david0ha/astra-cm5-nano/THIRD_PARTY.md

# Third-party notices

Original contributions are licensed under [CERN-OHL-P-2.0](LICENSE). The following material retains its own terms.

| Material | Attribution and terms |
|---|---|
| KiCad symbols and footprints embedded in the schematic and PCB | KiCad library contributors; CC-BY-SA-4.0 with the KiCad design-use exception. |
| `hardware/cm5-nano-compatible/NanoCompatible.pretty/SW_SPST_B3U-3000P.kicad_mod` and `USB3_A_Receptacle_Wuerth_692122030100_silk.kicad_mod` | Modified KiCad library footprints (silkscreen and property changes); CC-BY-SA-4.0 with the KiCad library exception. |
| `hardware/common/Carrier_Connectors.pretty/USB_C_GCT_USB4105_GroundClearance_020.kicad_mod` | Modified KiCad library footprint; ground-pad length changed from 1.15 mm to 1.10 mm. CC-BY-SA-4.0 with the KiCad library exception. |
| `hardware/cm5-nano-compatible/NanoCompatible.pretty/SDCARD_MOLEX_503398-1892.kicad_mod` and its embedded PCB copy | Raspberry Pi Ltd, CM5 IO Board footprint; 3D-model reference changed. Raspberry Pi design-file grant. |

KiCad library attribution and license: [official notice](https://www.kicad.org/libraries/license/), [library contributors](https://gitlab.com/kicad/libraries/), [included notice and exception](LICENSES/KiCad-library-license.md), [CC-BY-SA-4.0 full text](LICENSES/CC-BY-SA-4.0.txt).

Raspberry Pi attribution and terms: [official design-file licensing](https://www.raspberrypi.com/licensing/), [CM5 IO Board design files](https://pip.raspberrypi.com/categories/1098-design-files), [included grant and notice](LICENSES/Raspberry-Pi-design-notice.txt).

The original-contribution license does not relicense this material. Manufacturer 3D models and original Waveshare documents are not included. Product names identify their respective owners; no endorsement is implied.
