david0ha/astra-cm5-nano/docs/exports/schematic-focus-cm-pinmaps.png

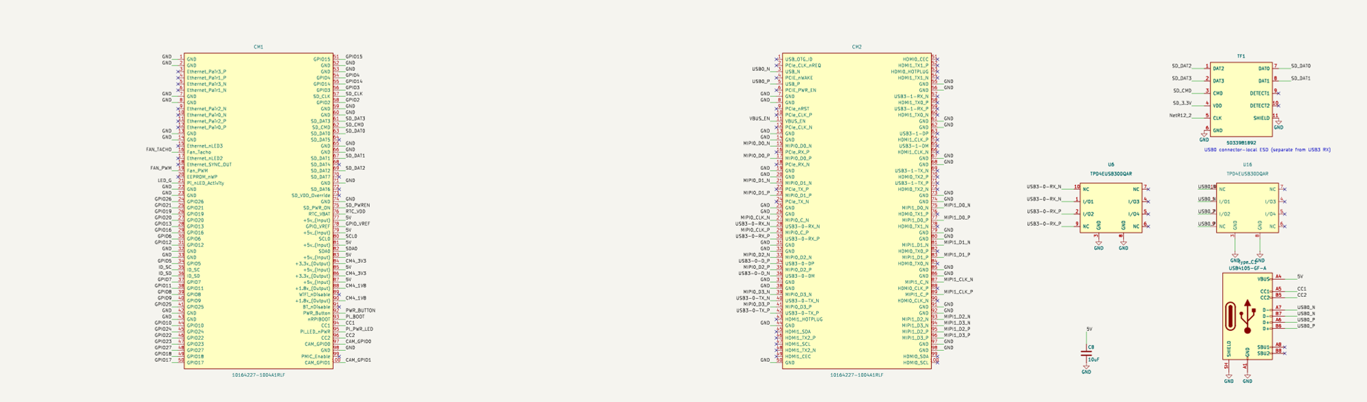
docs/exports/schematic-focus-cm-pinmaps.png
