david0ha/astra-cm5-nano/docs/exports/schematic-focus-mipi-gpio.png

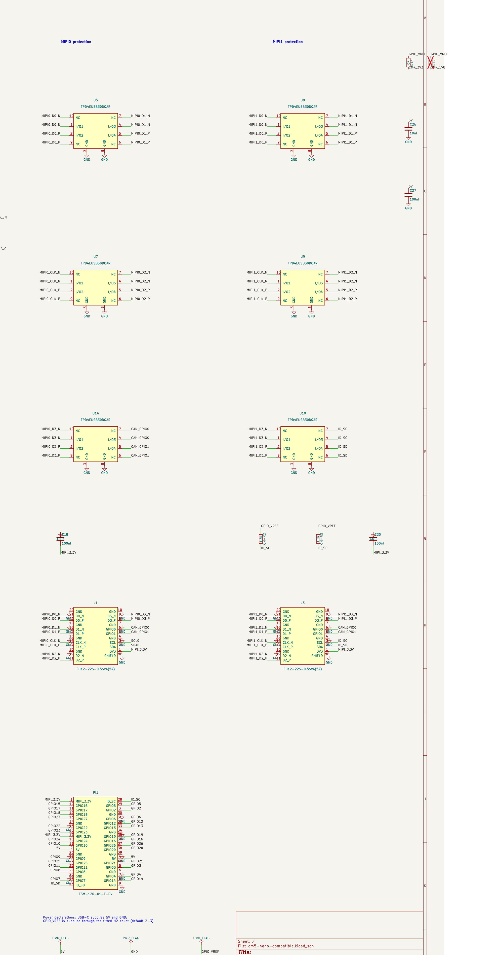
docs/exports/schematic-focus-mipi-gpio.png
