david0ha/astra-cm5-nano/docs/exports/schematic-focus-power-usb.png

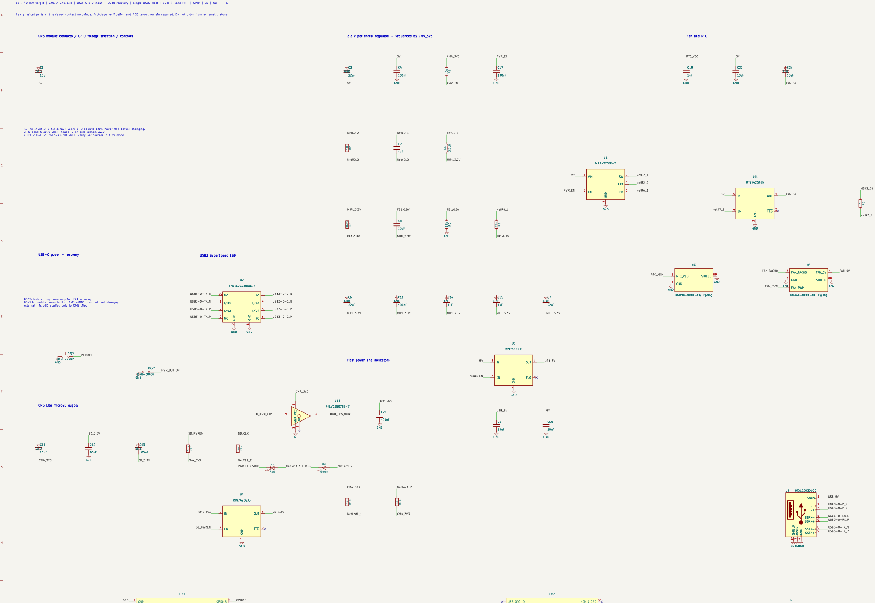
docs/exports/schematic-focus-power-usb.png
