david0ha/astra-cm5-nano/docs/exports/schematic-full.png

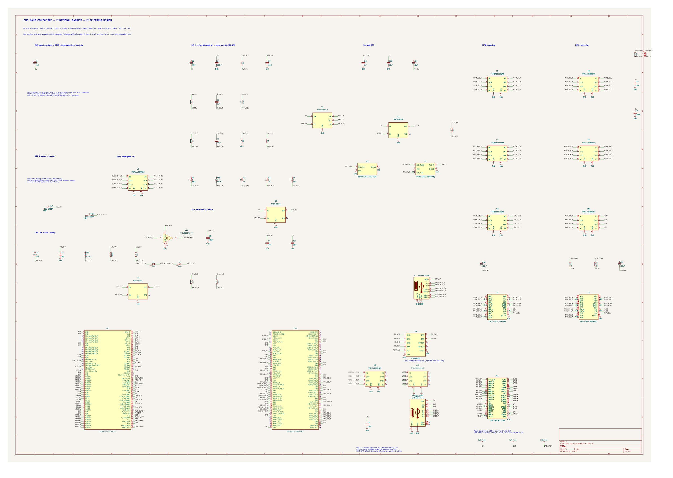
docs/exports/schematic-full.png
