david0ha/astra-cm5-nano/assembly/cm5-nano-compatible-BOM-detail.csv

Designator | Qty | Value | MPN | Footprint | LCSC | Catalogue MPN | MPN match | Stock as seen | Need for 5 boards | Library | URL | Sides | Mount
C1,C8,C9,C10,C11,C12,C23,C24,C26 | 9 | 10uF | GRM21BR61A106KE19L | Capacitor_SMD:C_0805_2012Metric | C77073 | GRM21BR61A106KE19L | exact | 8894 | 45 | expand | https://jlcpcb.com/partdetail/MurataElectronics-GRM21BR61A106KE19L/C77073 | B/F | SMD
C2,C14,C15,C19 | 4 | 1uF | GRM188R61A105KA61D | Capacitor_SMD:C_0603_1608Metric | C86012 | GRM188R61A105KA61D | exact | 37725 | 20 | expand | https://jlcpcb.com/partdetail/MurataElectronics-GRM188R61A105KA61D/C86012 | F | SMD
C3,C6,C7 | 3 | 22uF | CL21A226MQQNNNE | Capacitor_SMD:C_0805_2012Metric | C5674 | CL21A226MQQNNNE | exact | 4279129 | 15 | expand | https://jlcpcb.com/partdetail/6133-CL21A226MQQNNNE/C5674 | F | SMD
C4,C13,C16,C17,C18,C20,C25,C27 | 8 | 100nF | GRM188R71C104KA01D | Capacitor_SMD:C_0603_1608Metric | C45000 | GRM188R71C104KA01D | exact | 56256 | 40 | expand | https://jlcpcb.com/partdetail/MurataElectronics-GRM188R71C104KA01D/C45000 | B/F | SMD
C5 | 1 | 15pF | CL10C150JB8NNNC | Capacitor_SMD:C_0603_1608Metric | C1644 | CL10C150JB8NNNC | exact | 1044006 | 5 | base | https://jlcpcb.com/partdetail/1996-CL10C150JB8NNNC/C1644 | F | SMD
CM1,CM2 | 2 | 10164227-1004A1RLF | 10164227-1004A1RLF | Carrier_Connectors:Amphenol_10164227_1004A1RLF | C7435219 | 10164227-1004A1RLF | exact | 1118 | 10 | expand | https://jlcpcb.com/partdetail/AmphenolICC-101642271004A1RLF/C7435219 | B | SMD
CM-R2,CM-R3 | 2 | 1.8k | RC0402FR-071K8L | Resistor_SMD:R_0402_1005Metric | C163481 | RC0402FR-071K8L | exact | 351338 | 10 | expand | https://jlcpcb.com/partdetail/YAGEO-RC0402FR071K8L/C163481 | B | SMD
D1 | 1 | Red | LTST-C190KRKT | LED_SMD:LED_0603_1608Metric | C94869 | LTST-C190KRKT | exact | 388879 | 5 | expand | https://jlcpcb.com/partdetail/LiteOn-LTSTC190KRKT/C94869 | F | SMD
D2 | 1 | Green | LTST-C190KGKT | LED_SMD:LED_0603_1608Metric | C125094 | LTST-C190KGKT | exact | 740086 | 5 | expand | https://jlcpcb.com/partdetail/LiteOn-LTSTC190KGKT/C125094 | F | SMD
H3 | 1 | BM02B-SRSS-TB(LF)(SN) | BM02B-SRSS-TB(LF)(SN) | Connector_JST:JST_SH_BM02B-SRSS-TB_1x02-1MP_P1.00mm_Vertical | C160388 | BM02B-SRSS-TB(LF)(SN) | exact | 31049 | 5 | expand | https://jlcpcb.com/partdetail/JST-BM02B_SRSS_TB_LF_SN/C160388 | F | SMD
H4 | 1 | BM04B-SRSS-TB(LF)(SN) | BM04B-SRSS-TB(LF)(SN) | Connector_JST:JST_SH_BM04B-SRSS-TB_1x04-1MP_P1.00mm_Vertical | C160390 | BM04B-SRSS-TB(LF)(SN) | exact | 53090 | 5 | expand | https://jlcpcb.com/partdetail/JST-BM04B_SRSS_TB_LF_SN/C160390 | F | SMD
J1,J3 | 2 | FH12-22S-0.5SVA(54) | FH12-22S-0.5SVA(54) | NanoCompatible:Hirose_FH12-22S-0.5SVA_22P_Vertical | C6250833 | FH12-22S-0.5SVA(54) | exact | 45 | 10 | expand | https://jlcpcb.com/partdetail/HRS_Hirose-FH12_22S_0_5SVA_54/C6250833 | F | SMD
J2 | 1 | 692122030100 | 692122030100 | NanoCompatible:USB3_A_Receptacle_Wuerth_692122030100_silk | C5355286 | 692122030100 | exact | 78 | 5 | expand | https://jlcpcb.com/partdetail/WurthElektronik-692122030100/C5355286 | F | SMD
Key1,Key2 | 2 | B3U-3000P | B3U-3000P | NanoCompatible:SW_SPST_B3U-3000P | C963349 | B3U-3000P | exact | 22033 | 10 | expand | https://jlcpcb.com/partdetail/OmronElectronics-B3U3000P/C963349 | F | SMD
L1 | 1 | 3.3uH | XAL5030-332MEC | Inductor_SMD:L_Coilcraft_XAL5030-XXX | C5342047 | XAL5030-332MEC | exact | 513 | 5 | expand | https://jlcpcb.com/partdetail/Coilcraft-XAL5030332MEC/C5342047 | F | SMD
PI1 | 1 | TSM-120-01-T-DV | TSM-120-01-T-DV | NanoCompatible:Samtec_TSM-120-01-L-DV-P-TR_2x20_P2.54mm | C6723336 | TSM-120-01-T-DV | exact | 57 | 5 | expand | https://jlcpcb.com/partdetail/Samtec-TSM_120_01_TDV/C6723336 | F | SMD
R2 | 1 | 10 | RC0402FR-0710RL | Resistor_SMD:R_0402_1005Metric | C138066 | RC0402FR-0710RL | exact | 1355467 | 5 | expand | https://jlcpcb.com/partdetail/YAGEO-RC0402FR0710RL/C138066 | F | SMD
R3 | 1 | 40.2k | RC0402FR-0740K2L | Resistor_SMD:R_0402_1005Metric | C137983 | RC0402FR-0740K2L | exact | 1453343 | 5 | expand | https://jlcpcb.com/partdetail/YAGEO-RC0402FR0740K2L/C137983 | F | SMD
R5,R15 | 2 | 10k | RC0402FR-0710KL | Resistor_SMD:R_0402_1005Metric | C60490 | RC0402FR-0710KL | exact | 8053789 | 10 | expand | https://jlcpcb.com/partdetail/YAGEO-RC0402FR0710KL/C60490 | B/F | SMD
R6 | 1 | 75k | RC0402FR-0775KL | Resistor_SMD:R_0402_1005Metric | C137935 | RC0402FR-0775KL | exact | 167963 | 5 | expand | https://jlcpcb.com/partdetail/YAGEO-RC0402FR0775KL/C137935 | F | SMD
R7 | 1 | 0 | RC0402JR-070RL | Resistor_SMD:R_0402_1005Metric | C60485 | RC0402JR-070RL | exact | 8573741 | 5 | expand | https://jlcpcb.com/partdetail/YAGEO-RC0402JR070RL/C60485 | F | SMD
R9 | 1 | 13k | RC0402FR-0713KL | Resistor_SMD:R_0402_1005Metric | C138057 | RC0402FR-0713KL | exact | 385344 | 5 | expand | https://jlcpcb.com/partdetail/YAGEO-RC0402FR0713KL/C138057 | F | SMD
R10,R11 | 2 | 1k | RC0402FR-071KL | Resistor_SMD:R_0402_1005Metric | C106235 | RC0402FR-071KL | exact | 2606729 | 10 | expand | https://jlcpcb.com/partdetail/YAGEO-RC0402FR071KL/C106235 | B | SMD
R12 | 1 | 22 | RC0402FR-0722RL | Resistor_SMD:R_0402_1005Metric | C114765 | RC0402FR-0722RL | exact | 3732049 | 5 | expand | https://jlcpcb.com/partdetail/YAGEO-RC0402FR0722RL/C114765 | B | SMD
R16 | 1 | 0R | RC0402FR-070RL | Resistor_SMD:R_0402_1005Metric | C106231 | RC0402FR-070RL | exact | 326002 | 5 | expand | https://jlcpcb.com/partdetail/YAGEO-RC0402FR070RL/C106231 | F | SMD
TF1 | 1 | 5033981892 | 5033981892 | NanoCompatible:SDCARD_MOLEX_503398-1892 | C428492 | 5033981892 | exact | 23982 | 5 | expand | https://jlcpcb.com/partdetail/MOLEX-5033981892/C428492 | F | SMD
Type_C1 | 1 | USB4105-GF-A | USB4105-GF-A | Carrier_Connectors:USB_C_GCT_USB4105_GroundClearance_020 | C3020560 | USB4105-GF-A | exact | 777 | 5 | expand | https://jlcpcb.com/partdetail/3542626-USB4105_GFA/C3020560 | F | SMD
U1 | 1 | MP1477GTF-Z | MP1477GTF-Z | NanoCompatible:MP1658_SOT563_MPS | C3193189 | MP1477GTF-Z | exact | 101 | 5 | expand | https://jlcpcb.com/partdetail/Monolithic_PowerSystems-MP1477GTFZ/C3193189 | F | SMD
U2,U5,U6,U7,U8,U10,U14,U16 | 8 | TPD4EUSB30DQAR | TPD4EUSB30DQAR | Carrier_Connectors:TI_TPD4EUSB30_DQA0010A | C90627 | TPD4EUSB30DQAR | exact | 41267 | 40 | expand | https://jlcpcb.com/partdetail/TexasInstruments-TPD4EUSB30DQAR/C90627 | B/F | SMD
U3 | 1 | RT9742CGJ5 | RT9742CGJ5 | Package_TO_SOT_SMD:SOT-23-5 | C250546 | RT9742CGJ5 | exact | 17543 | 5 | expand | https://jlcpcb.com/partdetail/RichtekTech-RT9742CGJ5/C250546 | F | SMD
U4,U11 | 2 | RT9742GGJ5 | RT9742GGJ5 | Package_TO_SOT_SMD:SOT-23-5 | C250547 | RT9742GGJ5 | exact | 13072 | 10 | expand | https://jlcpcb.com/partdetail/RichtekTech-RT9742GGJ5/C250547 | F | SMD
U9 | 1 | TPD4EUSB30DQAR | TPD4EUSB30DQAR | NanoCompatible:TI_TPD4EUSB30_DQA0010A_U9 | C90627 | TPD4EUSB30DQAR | exact | 41267 | 5 | expand | https://jlcpcb.com/partdetail/TexasInstruments-TPD4EUSB30DQAR/C90627 | B | SMD
U15 | 1 | 74LVC1G07SE-7 | 74LVC1G07SE-7 | NanoCompatible:74LVC1G07_SOT353_Diodes | C67531 | 74LVC1G07SE-7 | exact | 10668 | 5 | expand | https://jlcpcb.com/partdetail/DiodesIncorporated-74LVC1G07SE7/C67531 | B | SMD
