david0ha/astra-cm5-nano/docs/exports/schematic-focused-pages.pdf

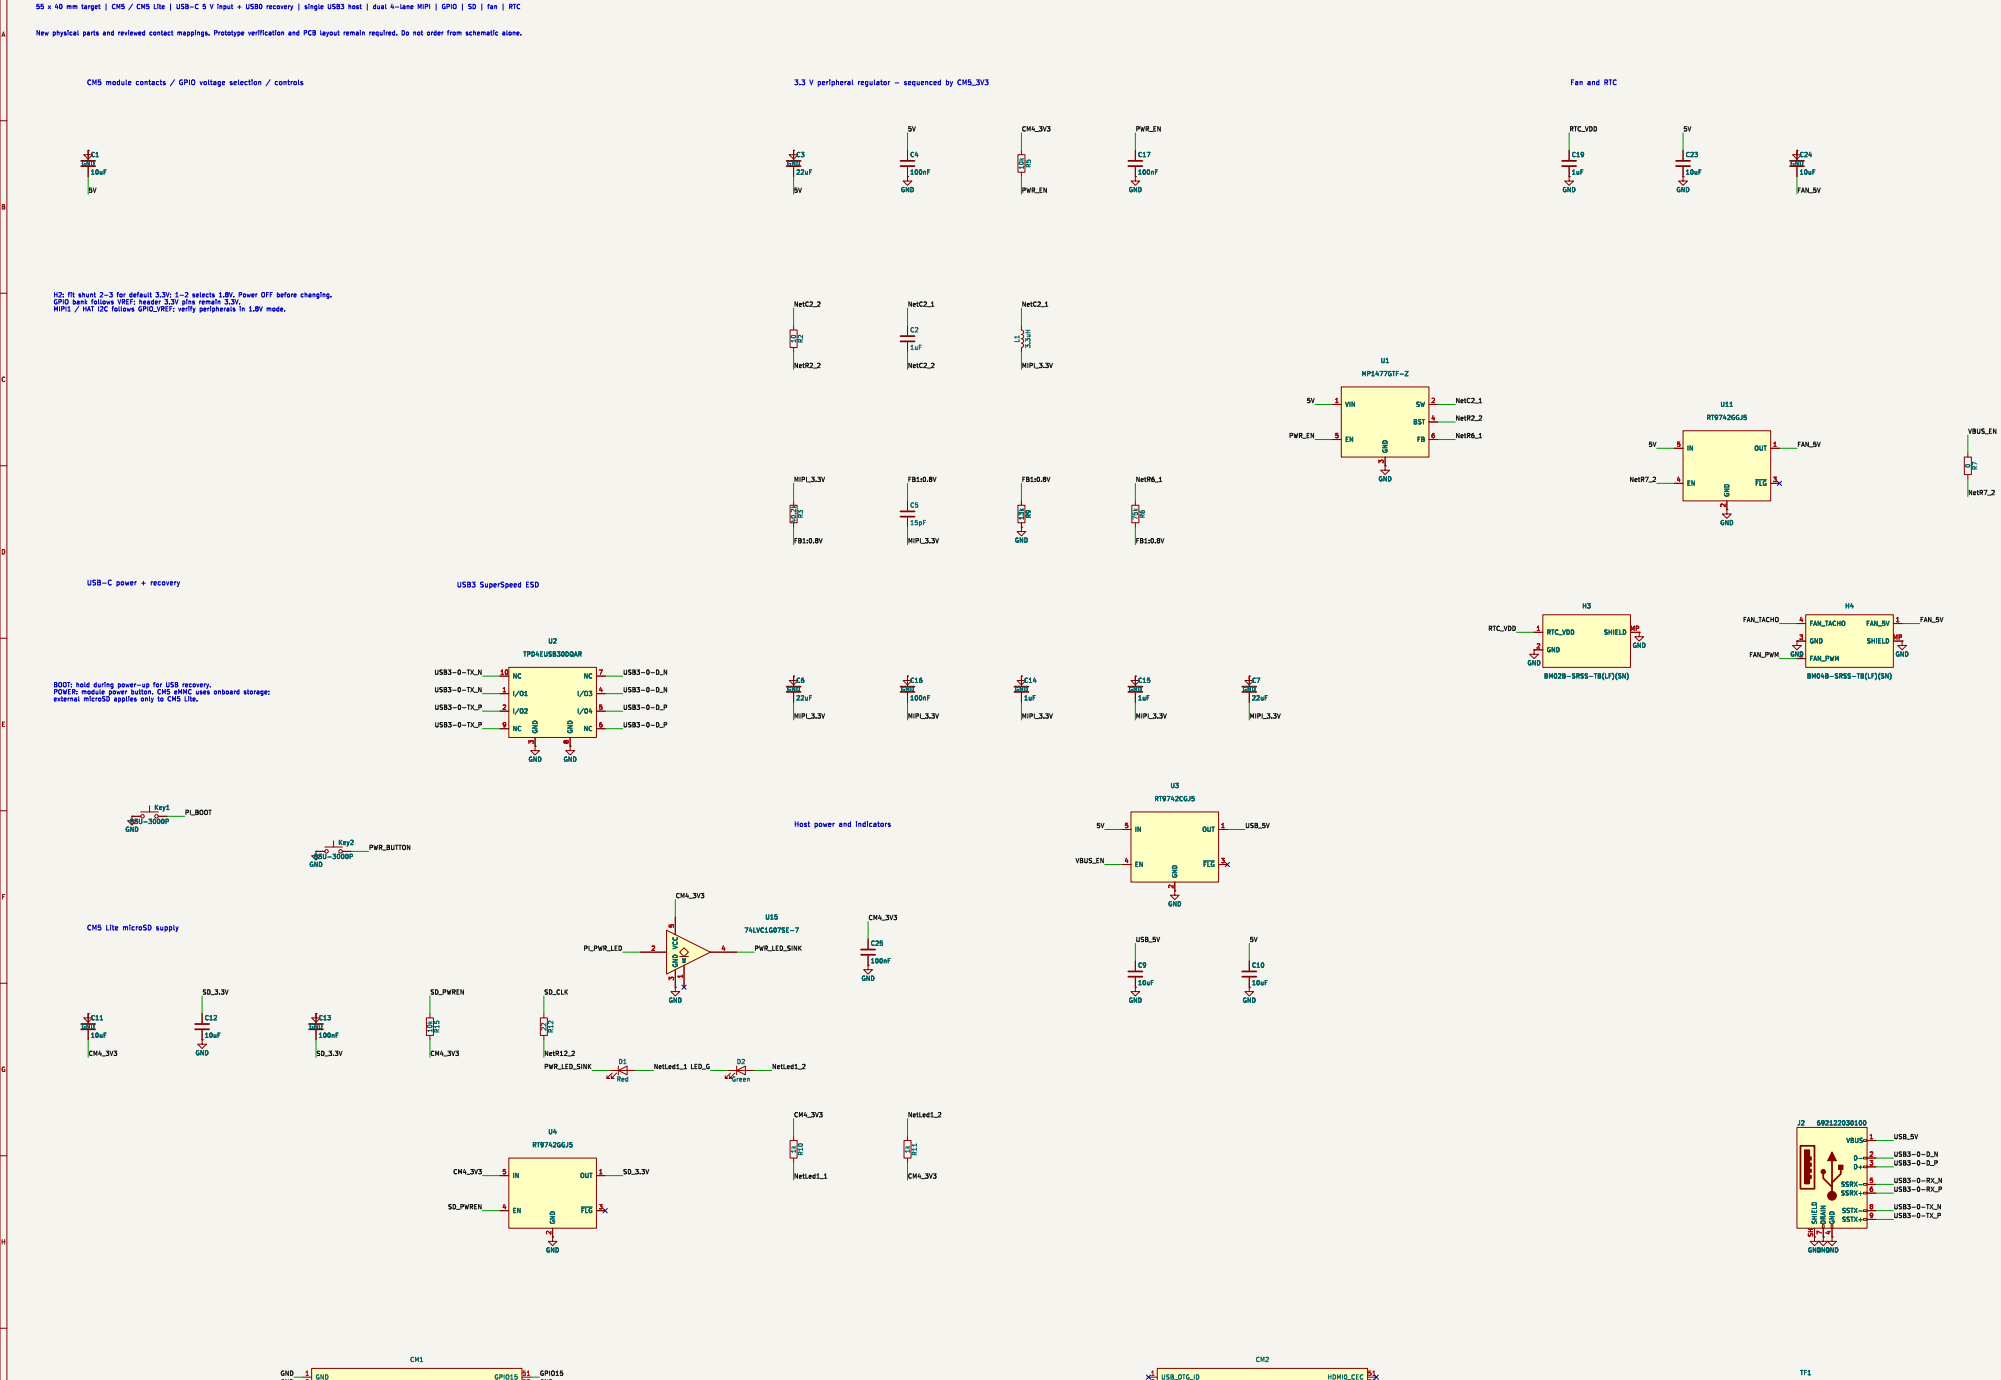
[picture p7: page 1]

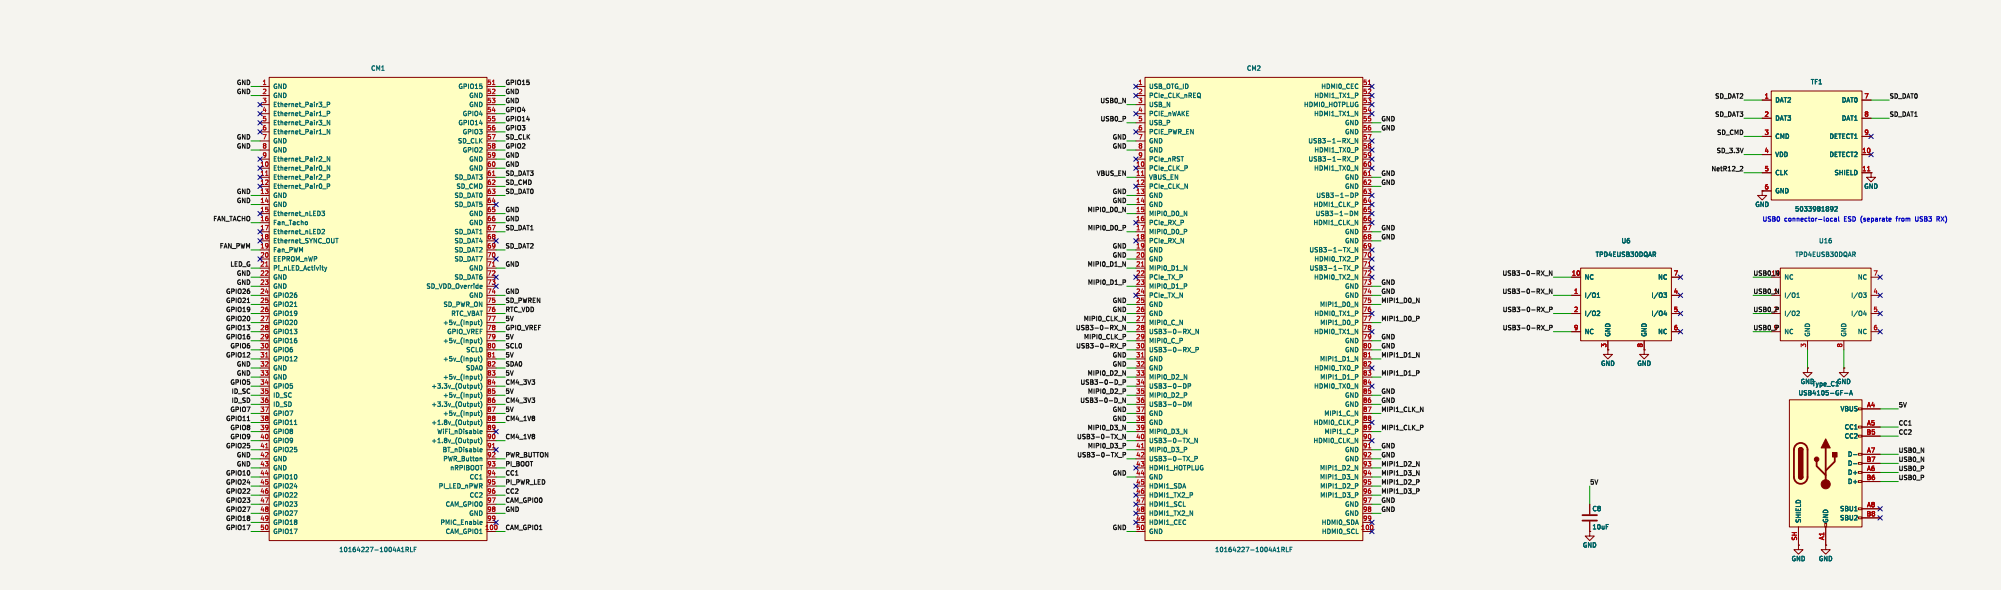
[picture p8: page 2]

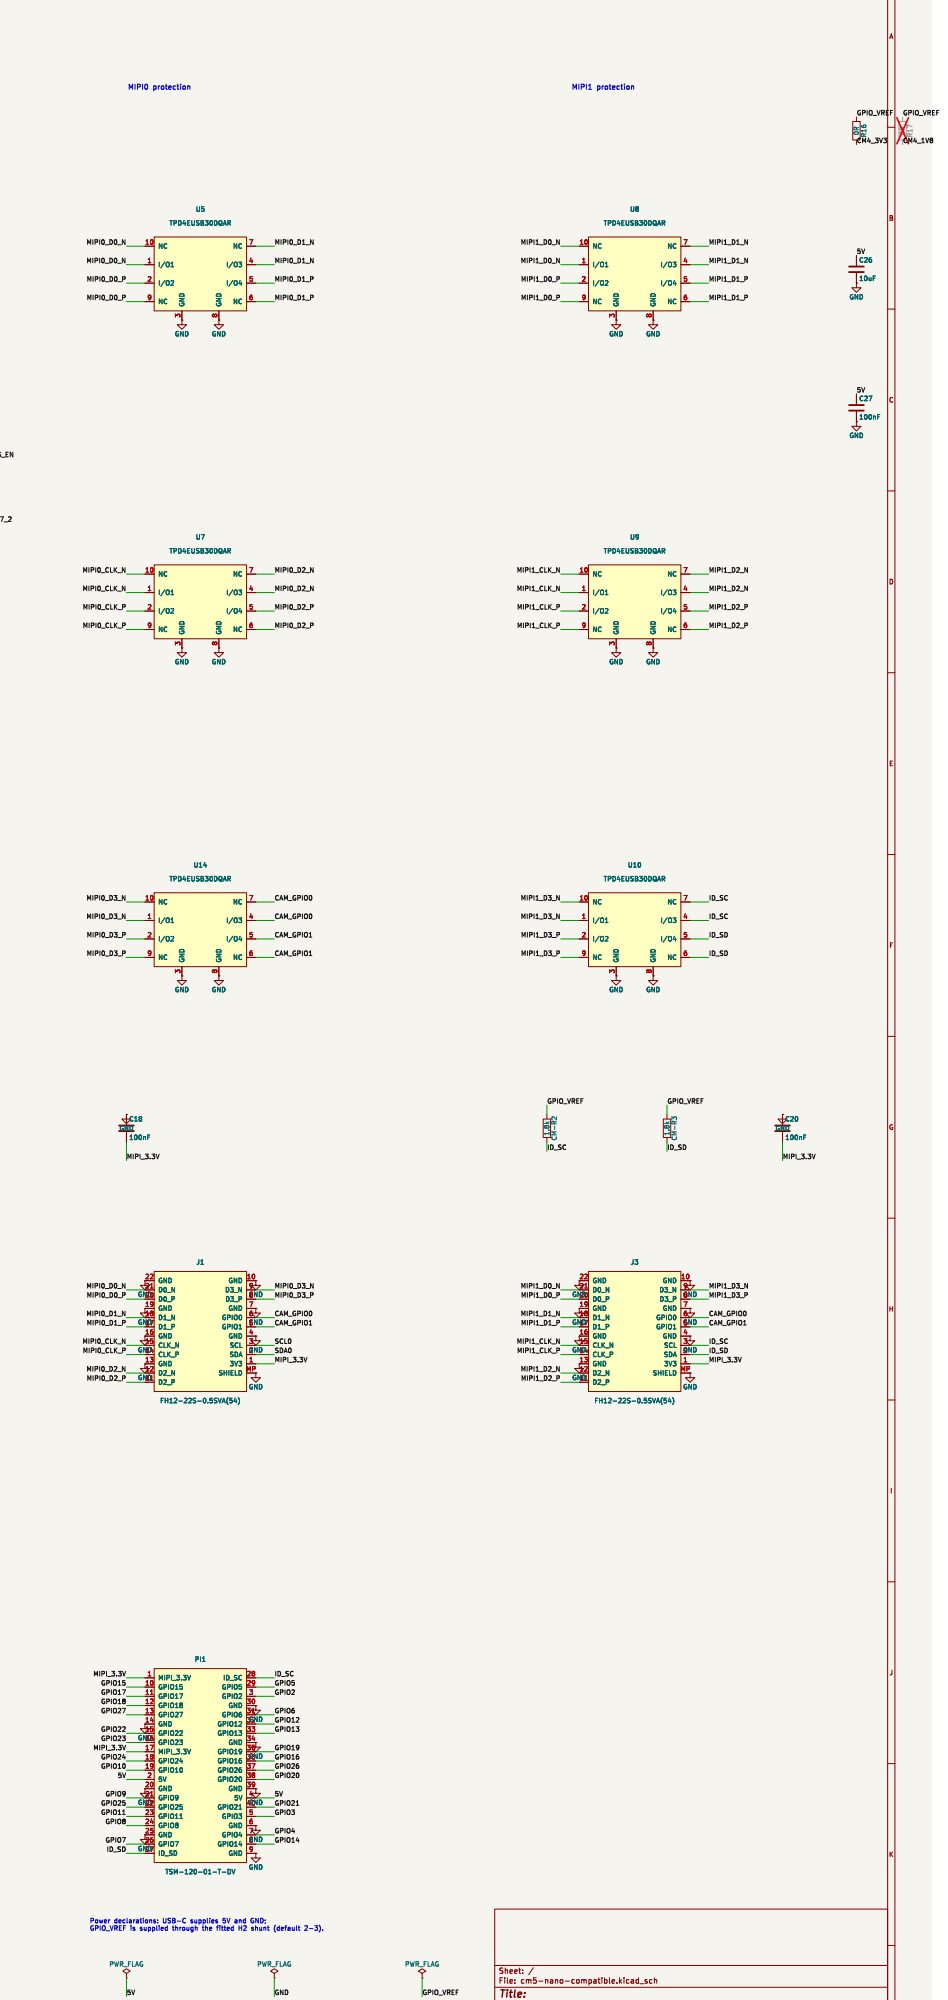
[picture p9: page 3]
