david0ha/astra-cm5-nano/docs/exports/schematic-full.pdf

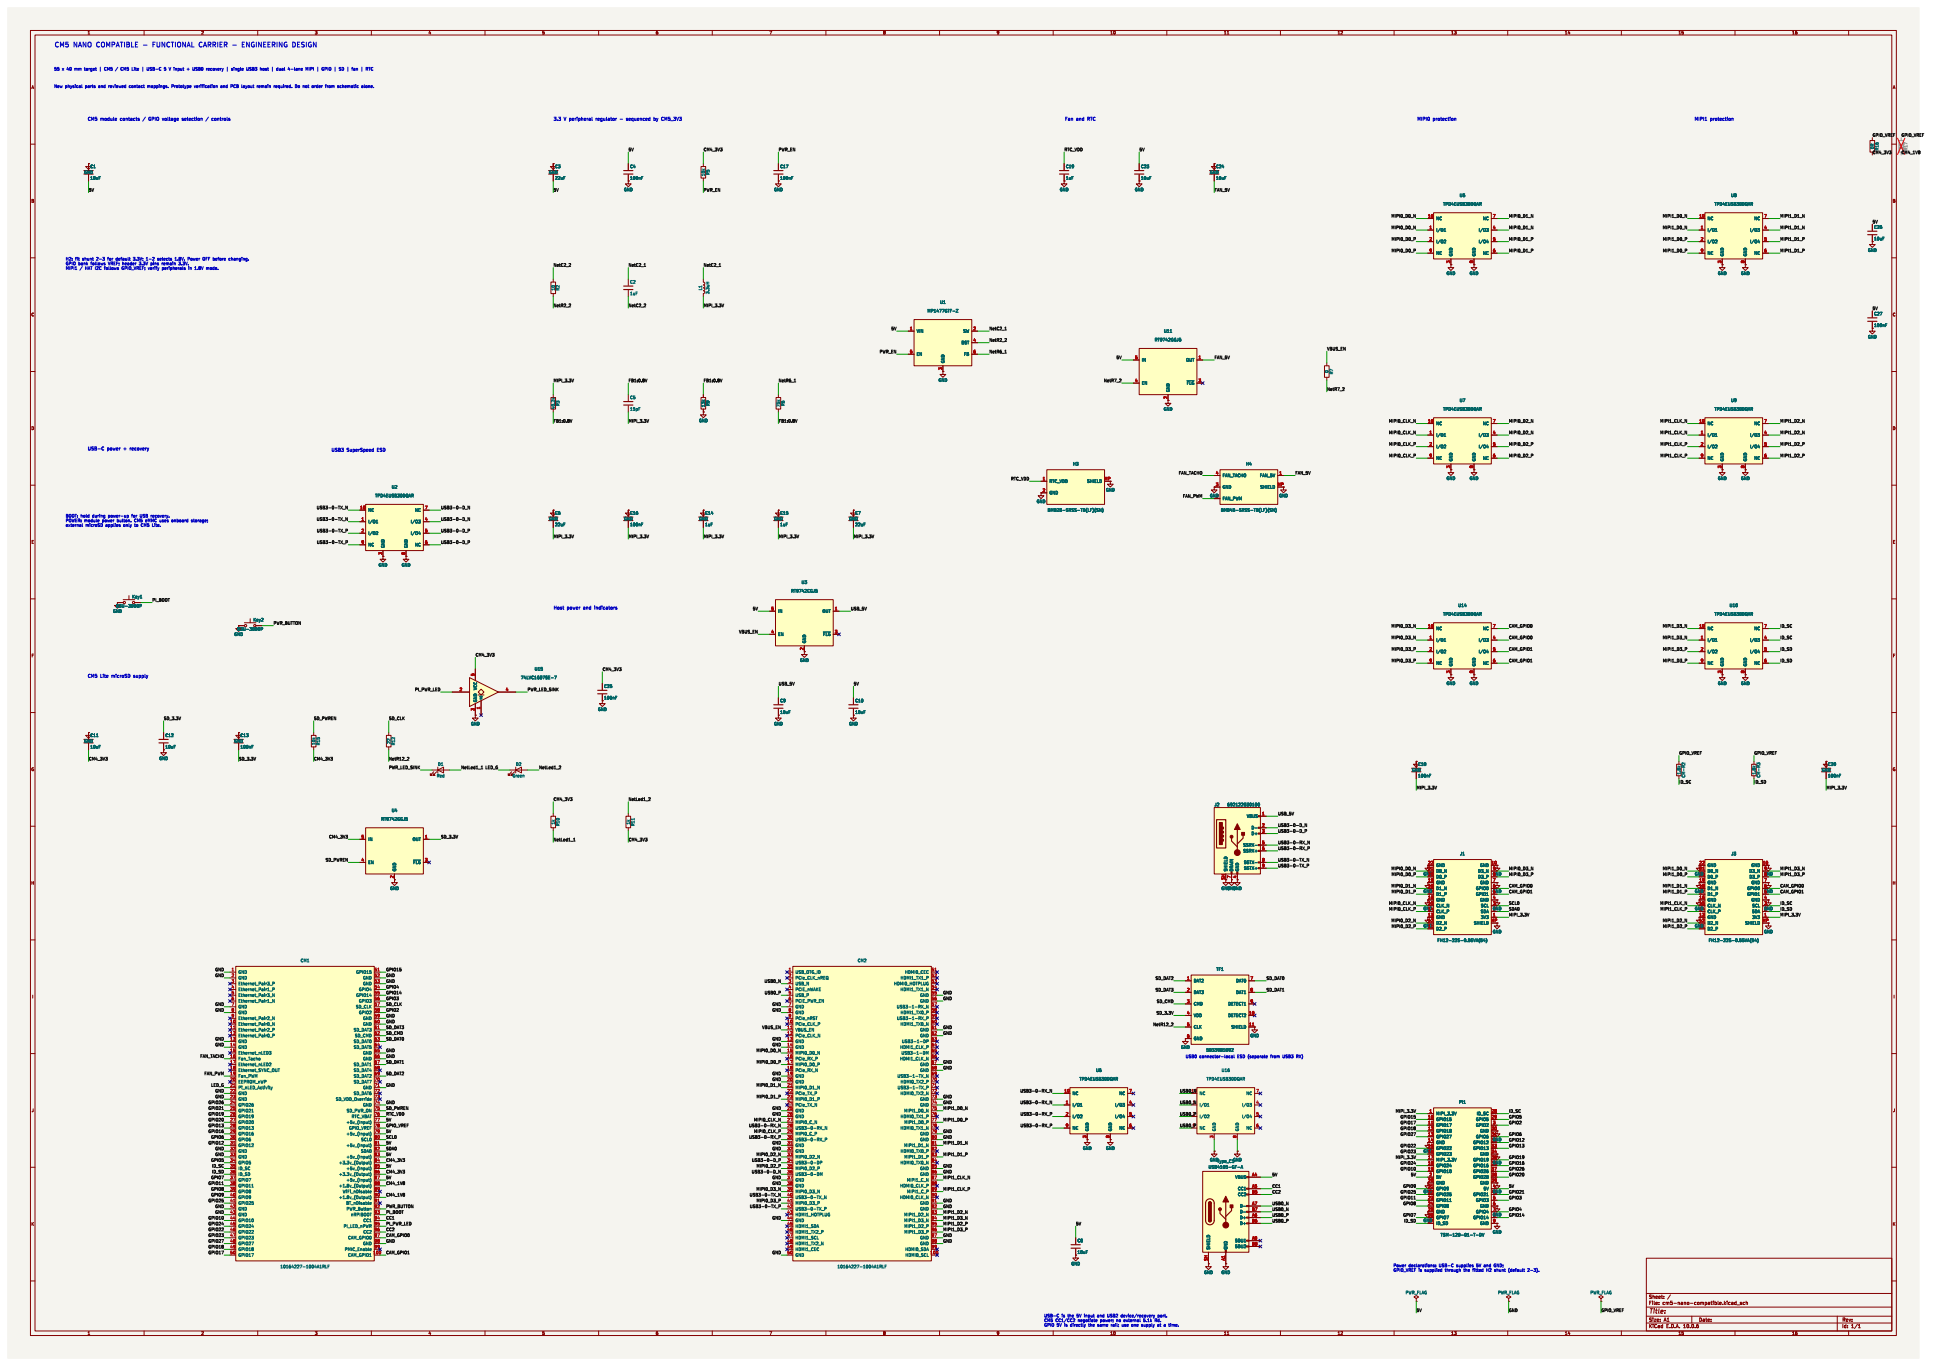
[picture p10: page 1]
