david0ha/astra-cm5-nano/docs/exports/pcb-layers.pdf

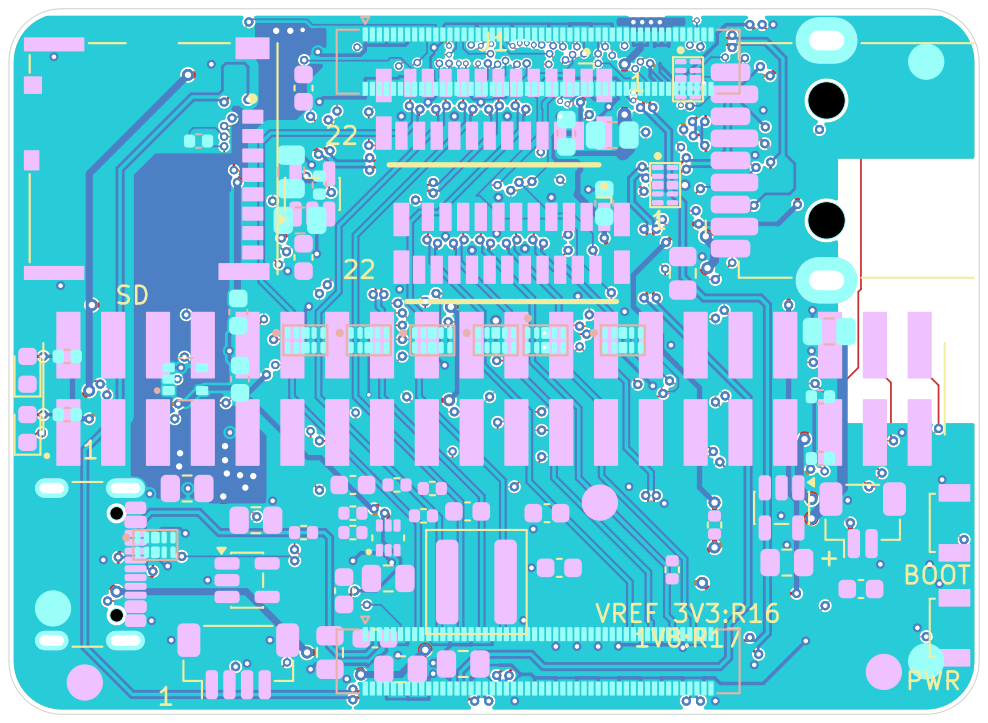
[picture p11: page 1]
