david0ha/astra-cm5-nano/hardware/cm5-nano-compatible/cm5-nano-compatible.kicad_pcb

## KiCad design hardware/cm5-nano-compatible/cm5-nano-compatible.kicad_pcb (2026-10-02)

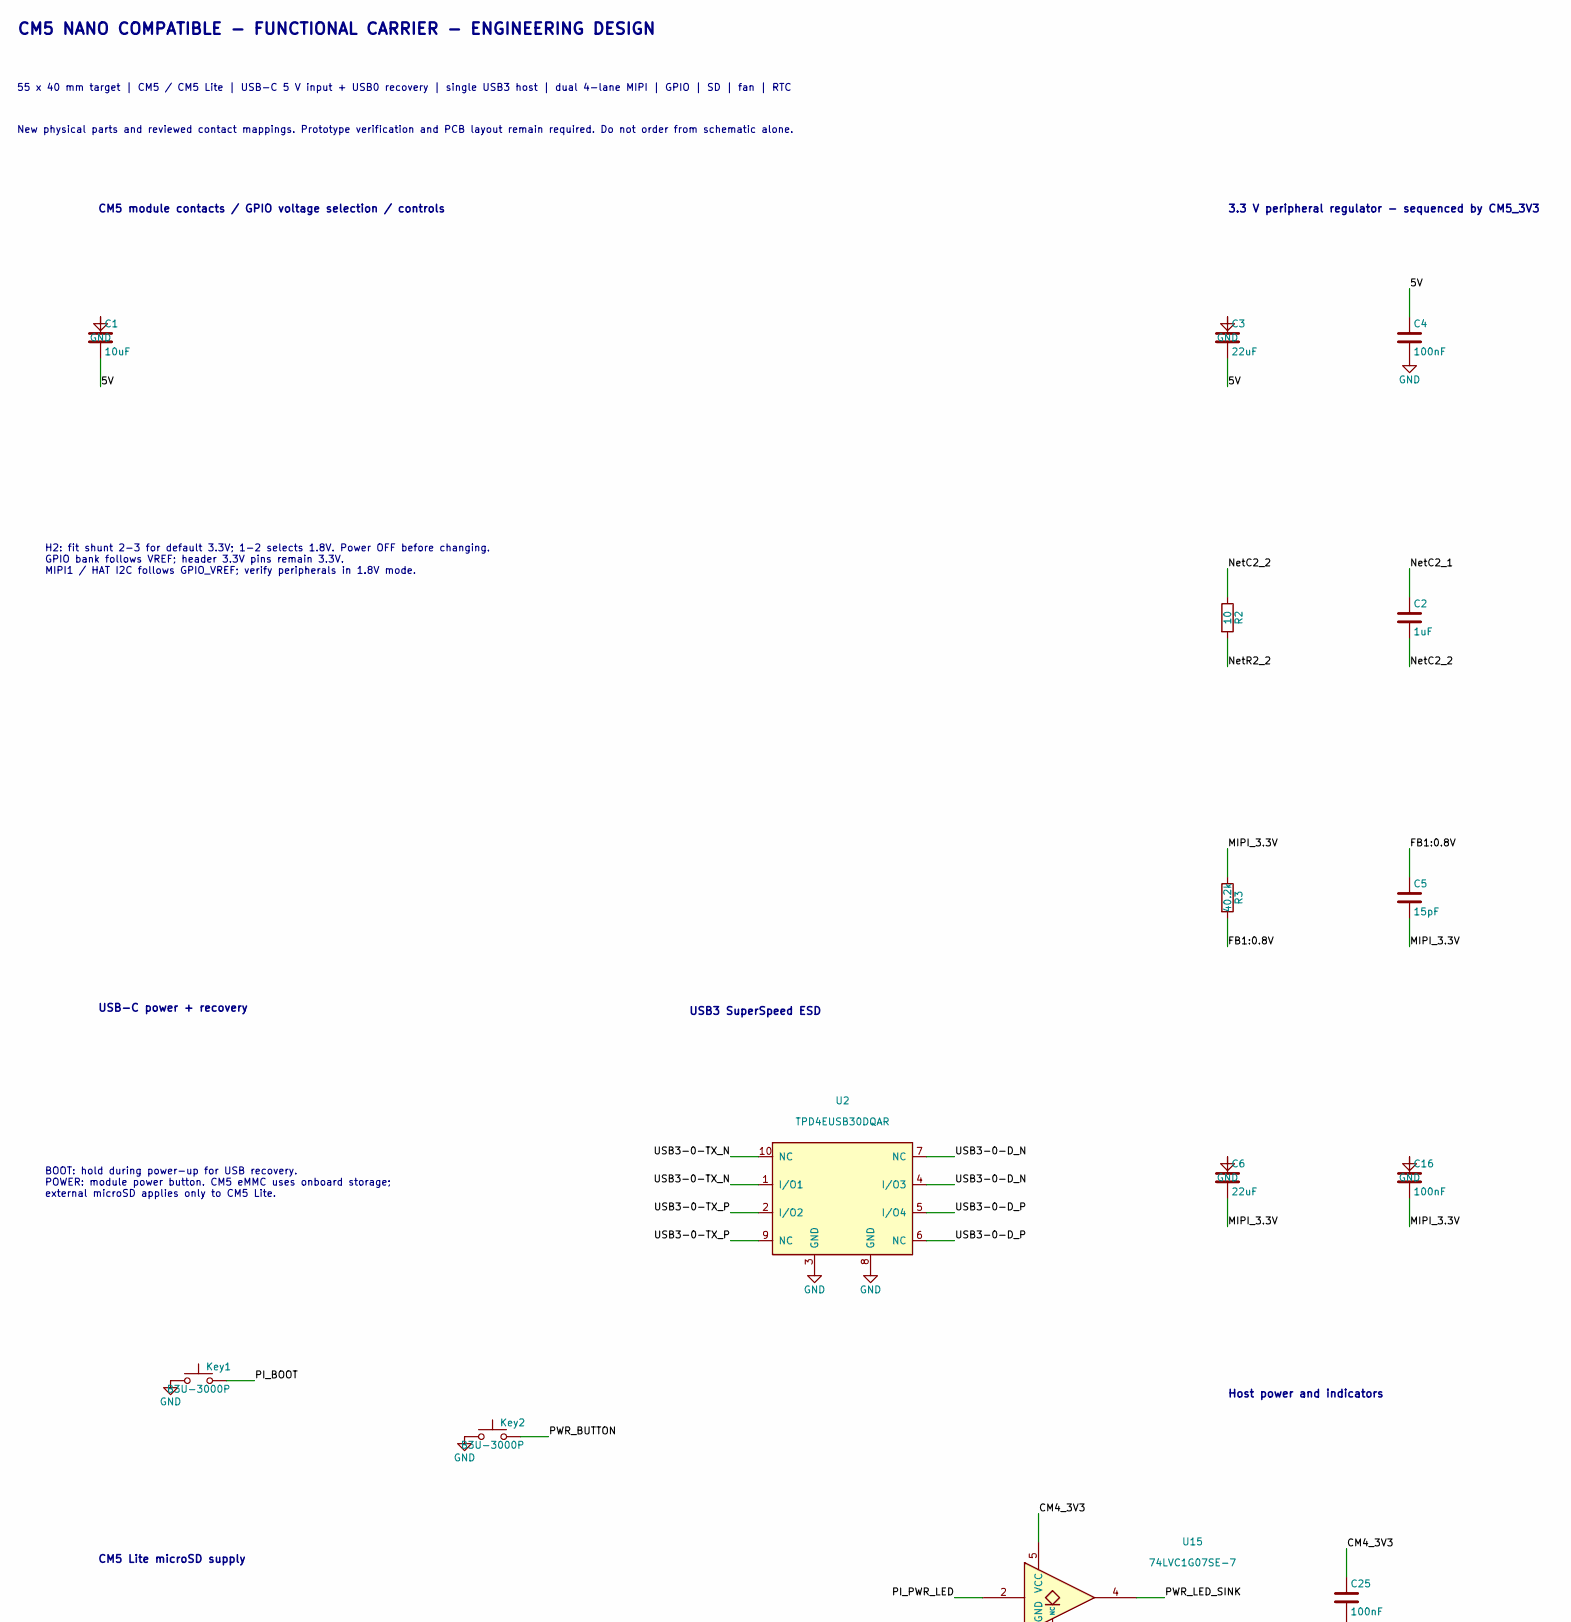
[picture p12: schematic cm5-nano-compatible.kicad_sch, part in row 1, column 1]

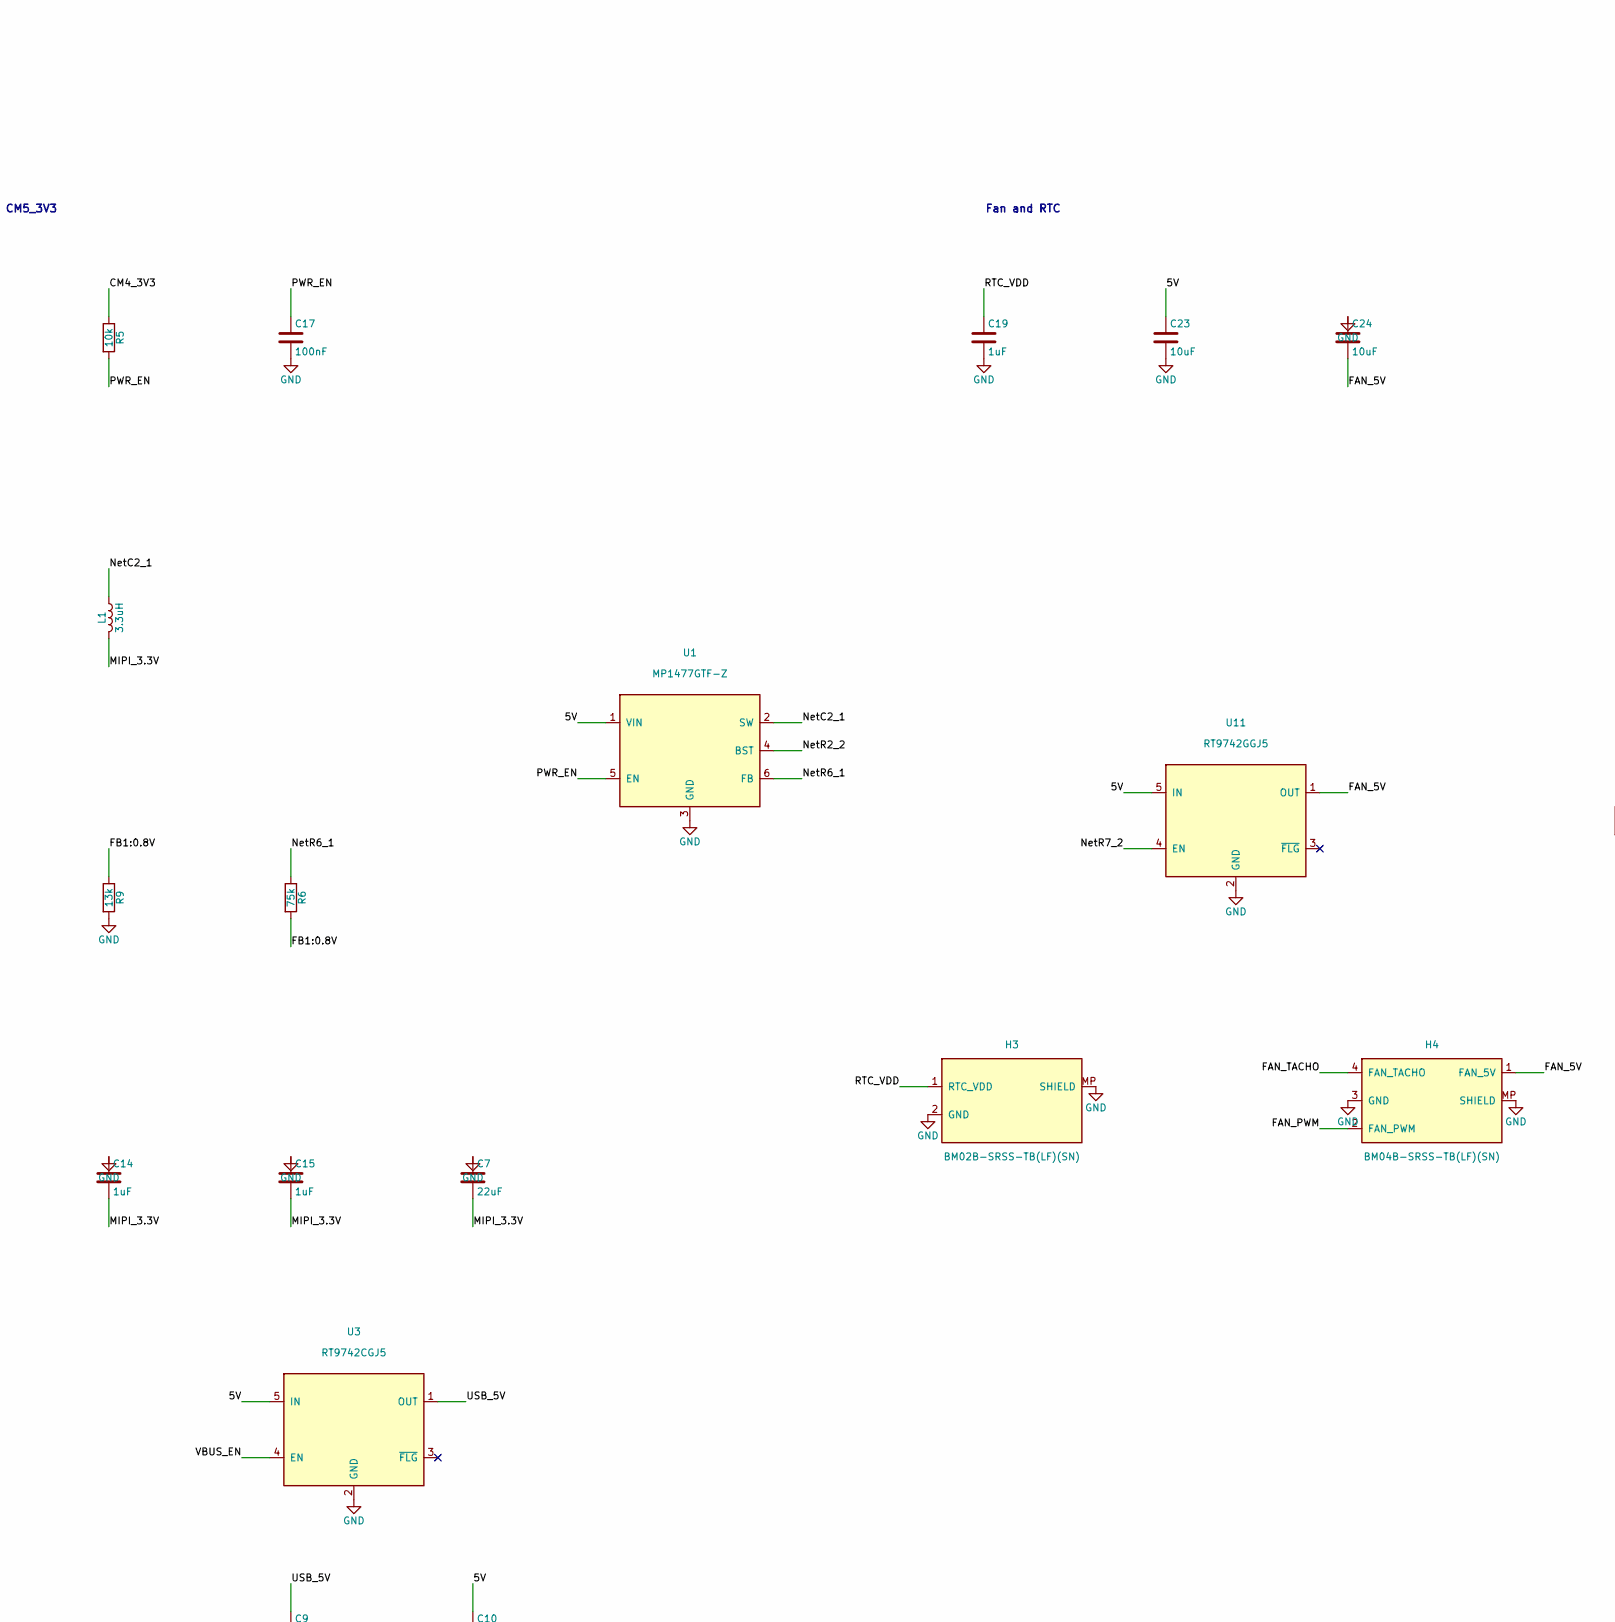
[picture p13: schematic cm5-nano-compatible.kicad_sch, part in row 1, column 2]

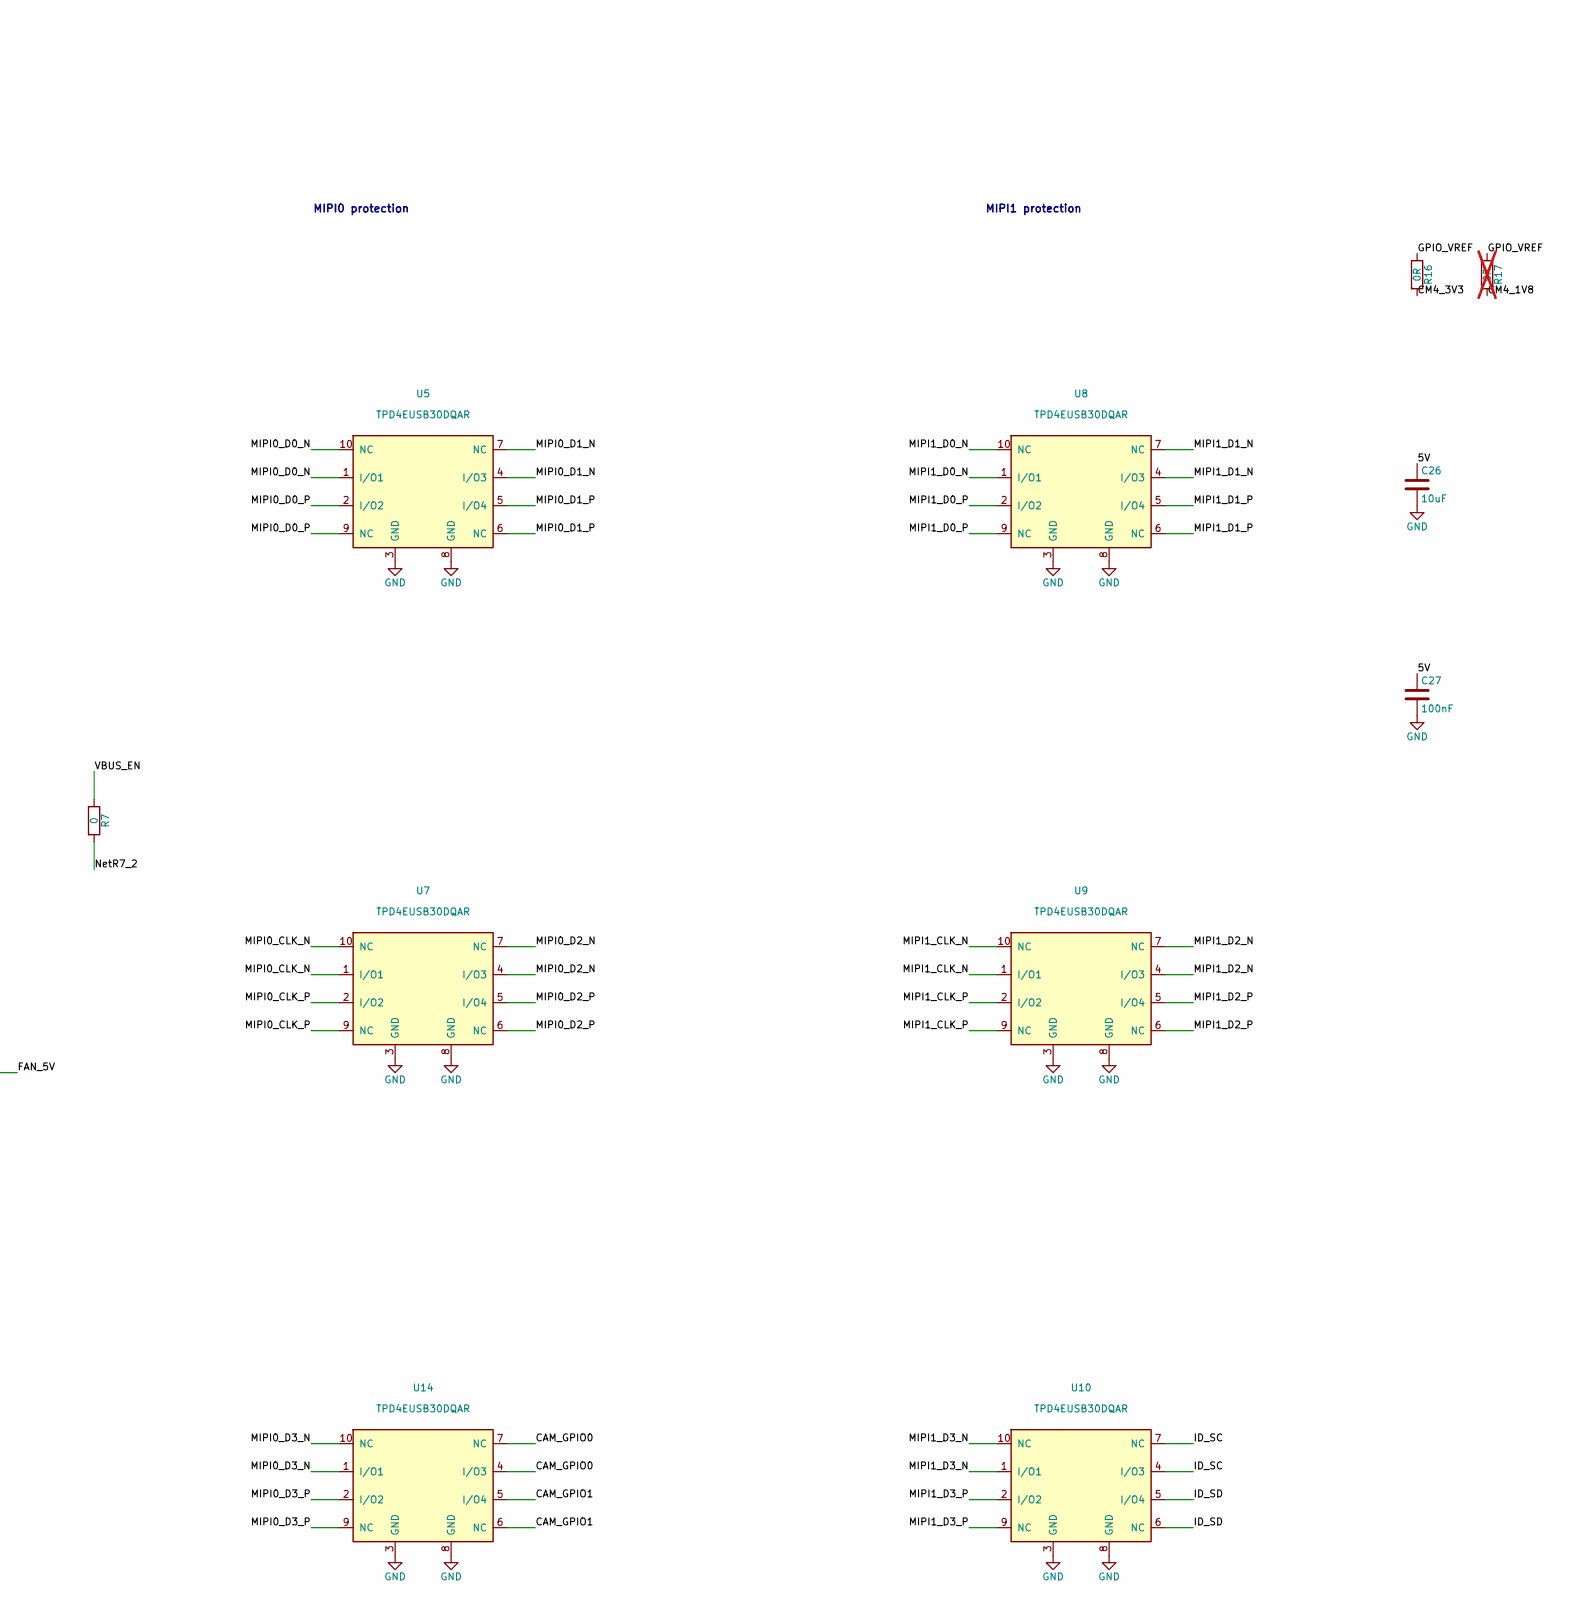
[picture p14: schematic cm5-nano-compatible.kicad_sch, part in row 1, column 3]

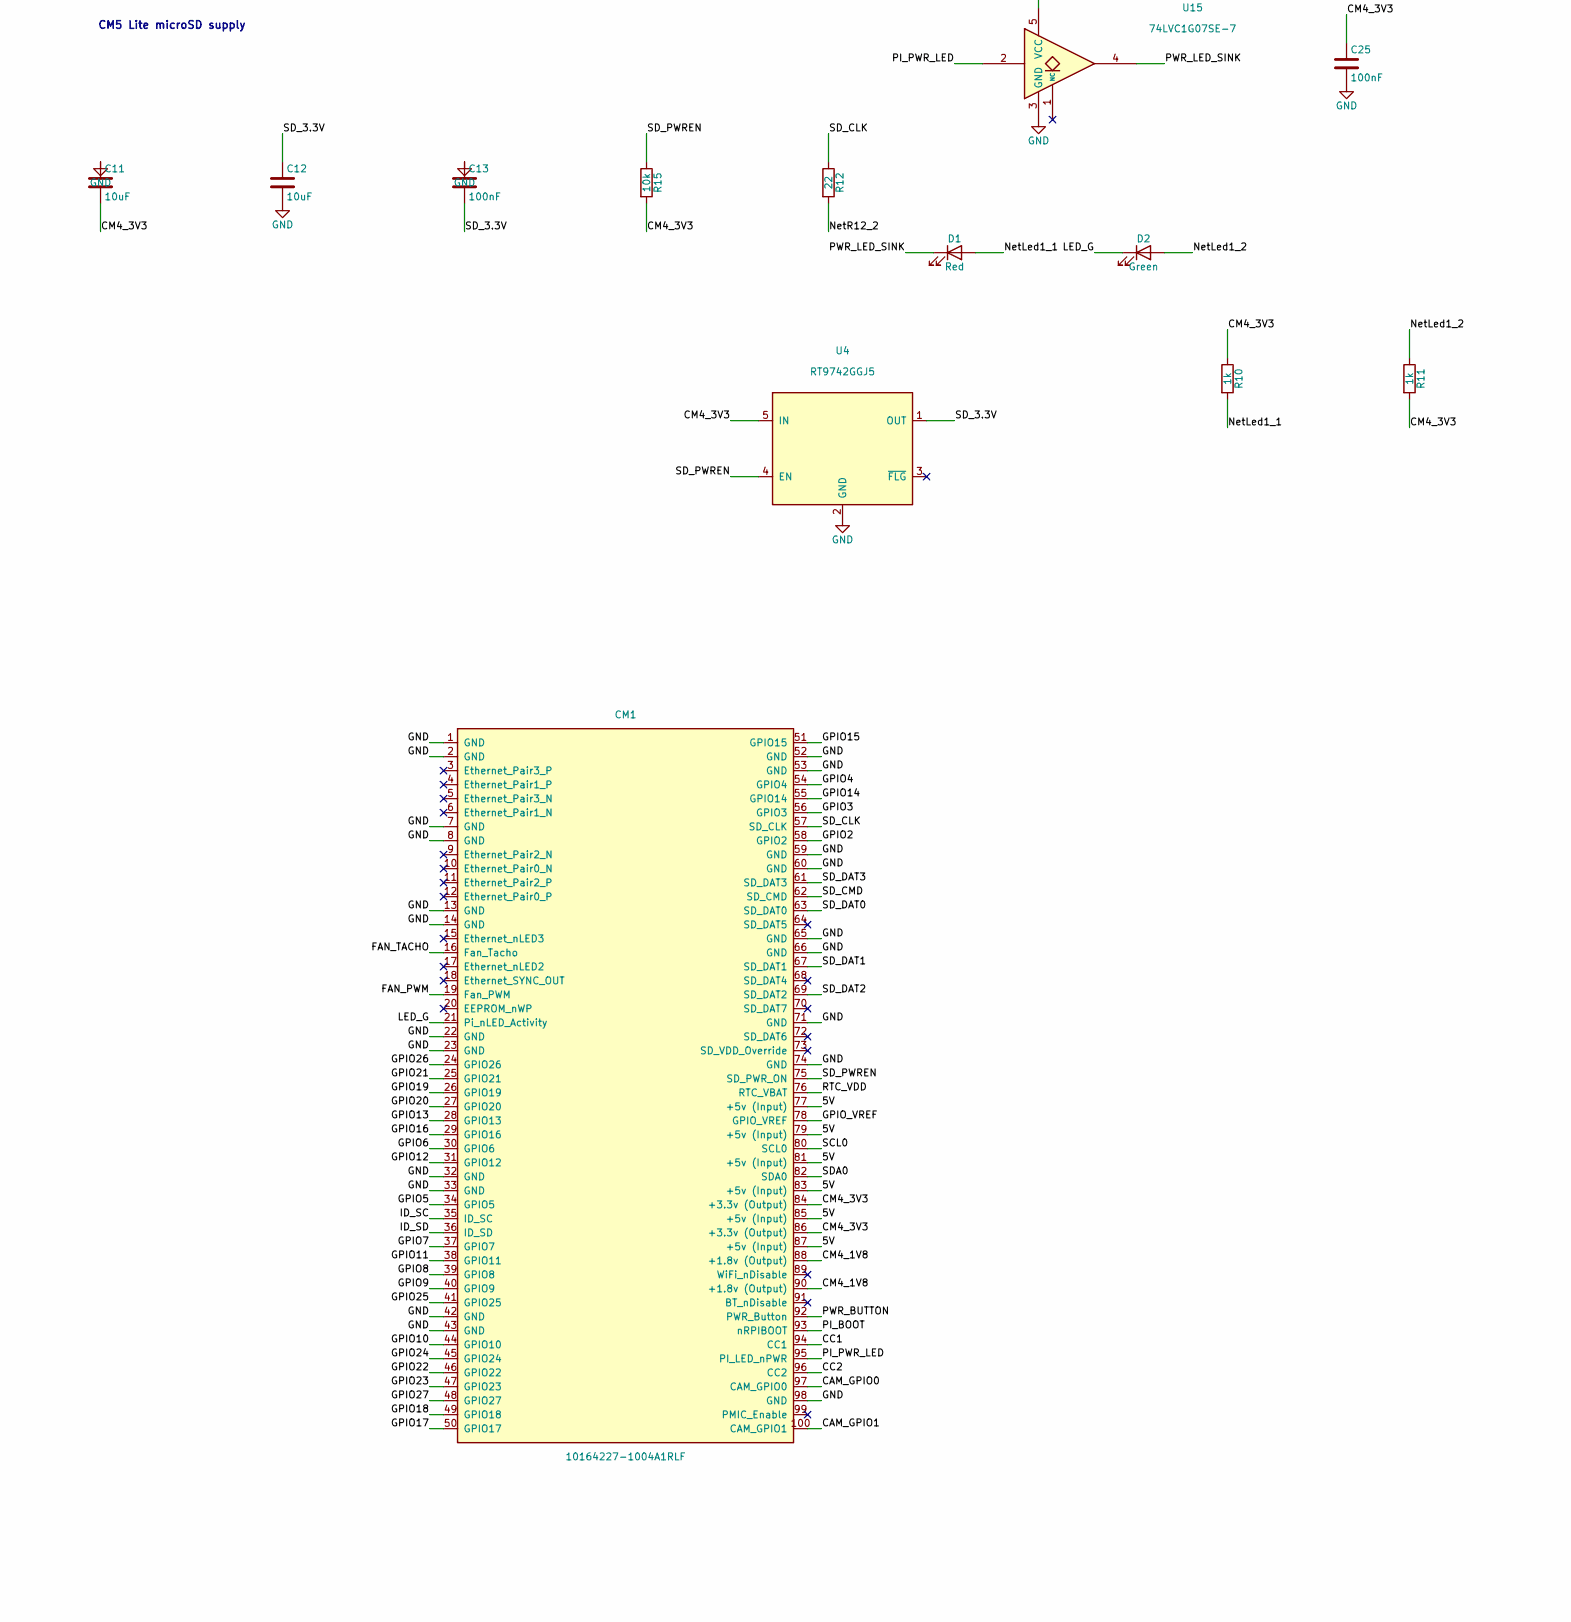
[picture p15: schematic cm5-nano-compatible.kicad_sch, part in row 2, column 1]

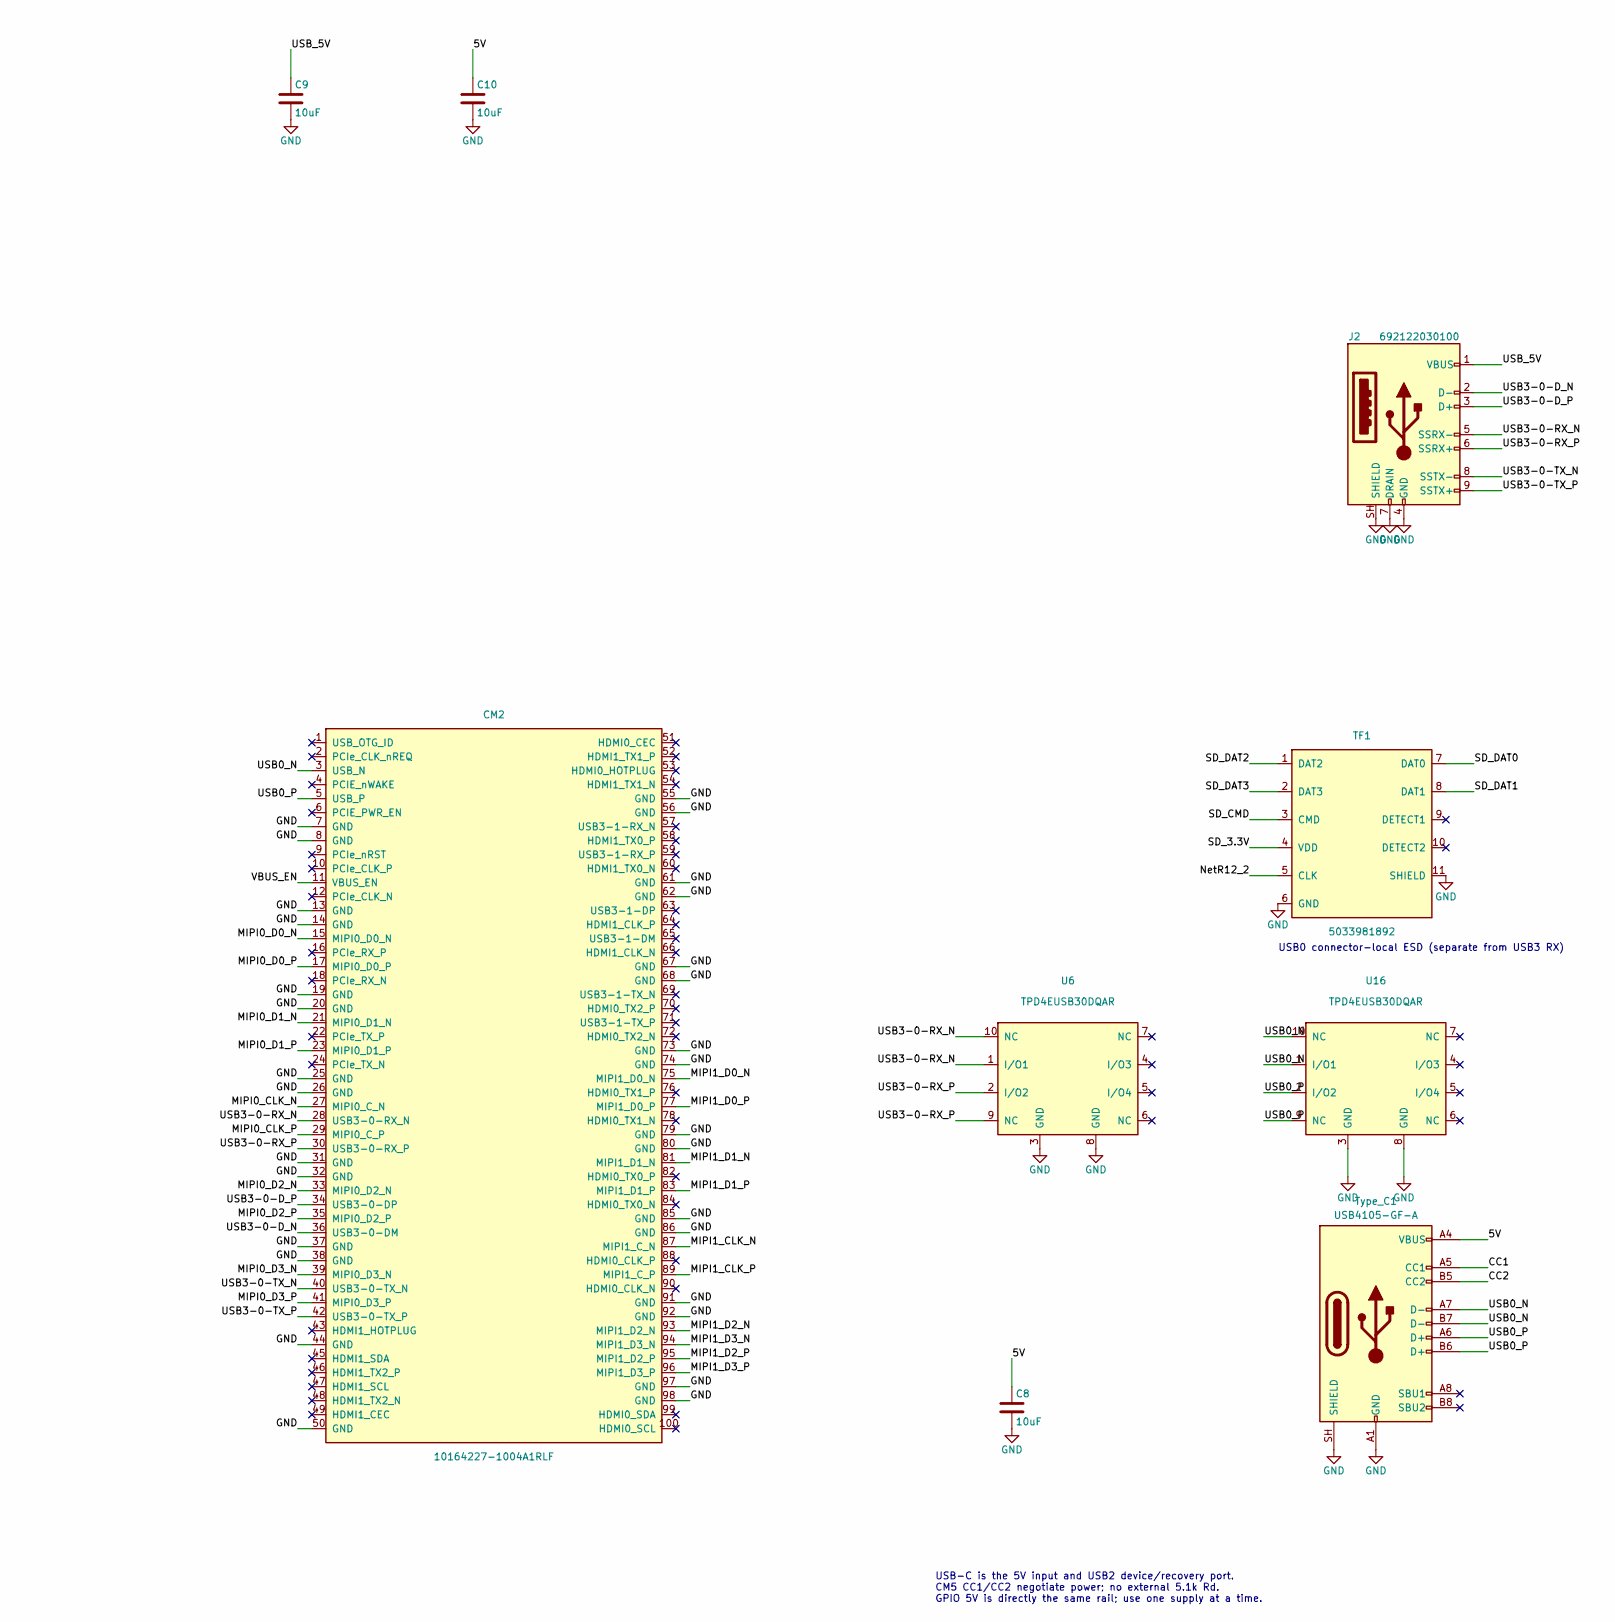
[picture p16: schematic cm5-nano-compatible.kicad_sch, part in row 2, column 2]

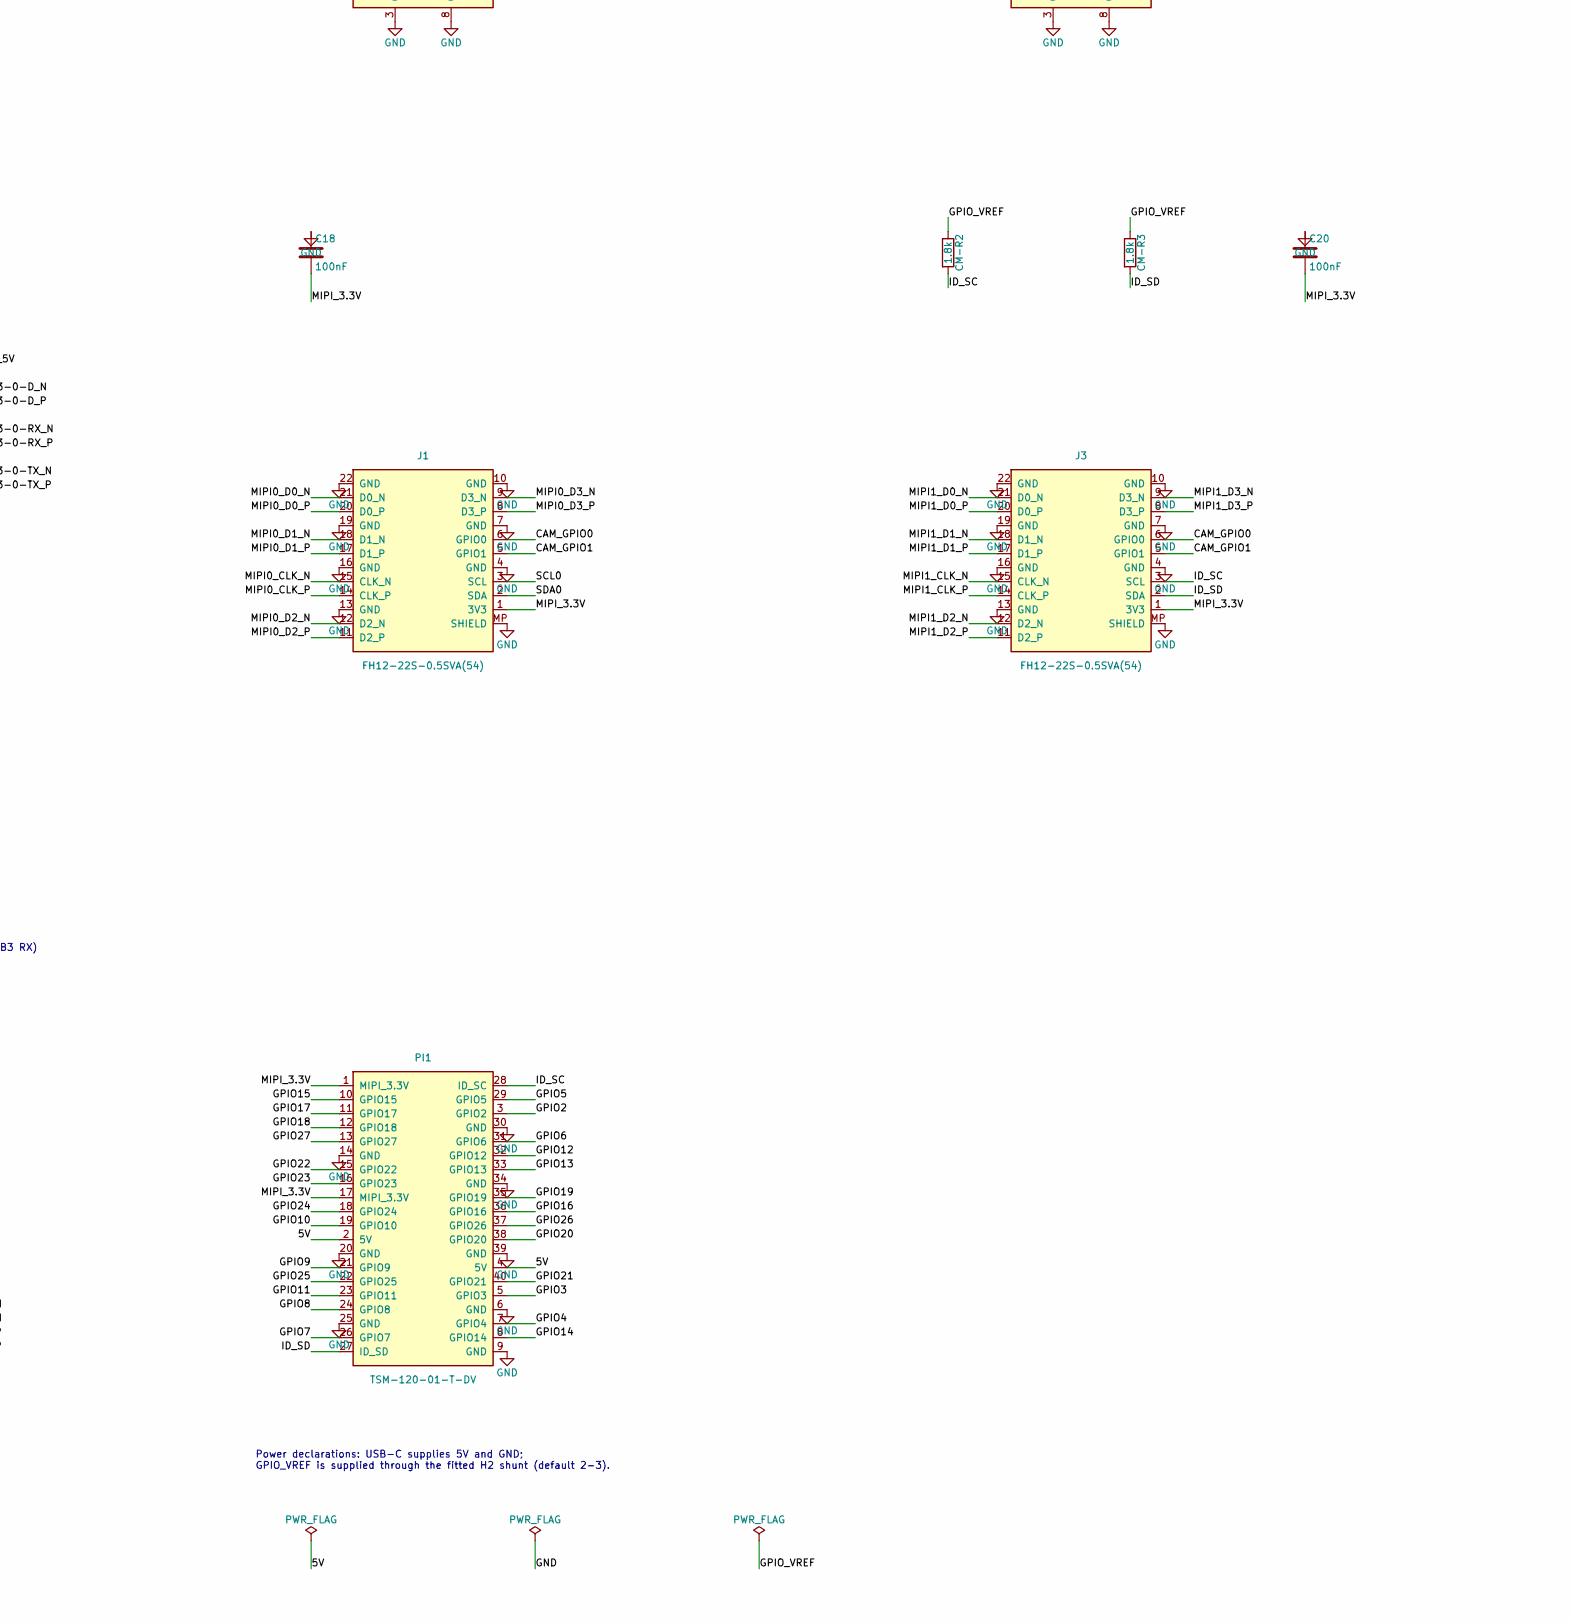
[picture p17: schematic cm5-nano-compatible.kicad_sch, part in row 2, column 3]

Parts:
C1, C8, C9, C10, C11, C12, C23, C24, C26: 10uF; C_0805_2012Metric; MPN GRM21BR61A106KE19L; LCSC C77073
C2, C14, C15, C19: 1uF; C_0603_1608Metric; MPN GRM188R61A105KA61D; LCSC C86012
C3, C6, C7: 22uF; C_0805_2012Metric; MPN CL21A226MQQNNNE; LCSC C5674
C4, C13, C16, C17, C18, C20, C25, C27: 100nF; C_0603_1608Metric; MPN GRM188R71C104KA01D; LCSC C45000
C5: 15pF; C_0603_1608Metric; MPN CL10C150JB8NNNC; LCSC C1644
CM1, CM2: 10164227-1004A1RLF; Amphenol_10164227_1004A1RLF; MPN 10164227-1004A1RLF; LCSC C7435219
CM-R2, CM-R3: 1.8k; R_0402_1005Metric; MPN RC0402FR-071K8L; LCSC C163481
D1: Red; LED_0603_1608Metric; MPN LTST-C190KRKT; LCSC C94869
D2: Green; LED_0603_1608Metric; MPN LTST-C190KGKT; LCSC C125094
H3: BM02B-SRSS-TB(LF)(SN); JST_SH_BM02B-SRSS-TB_1x02-1MP_P1.00mm_Vertical; MPN BM02B-SRSS-TB(LF)(SN); LCSC C160388
H4: BM04B-SRSS-TB(LF)(SN); JST_SH_BM04B-SRSS-TB_1x04-1MP_P1.00mm_Vertical; MPN BM04B-SRSS-TB(LF)(SN); LCSC C160390
J1, J3: FH12-22S-0.5SVA(54); Hirose_FH12-22S-0.5SVA_22P_Vertical; MPN FH12-22S-0.5SVA(54); JLCPCB_PN C6250833
J2: 692122030100; USB3_A_Receptacle_Wuerth_692122030100_silk; MPN 692122030100; LCSC C5355286
Key1, Key2: B3U-3000P; SW_SPST_B3U-3000P; MPN B3U-3000P; JLCPCB_PN C963349
L1: 3.3uH; L_Coilcraft_XAL5030-XXX; MPN XAL5030-332MEC; LCSC C5342047
PI1: TSM-120-01-T-DV; Samtec_TSM-120-01-L-DV-P-TR_2x20_P2.54mm; MPN TSM-120-01-T-DV; LCSC C6723336
R2: 10; R_0402_1005Metric; MPN RC0402FR-0710RL; LCSC C138066
R3: 40.2k; R_0402_1005Metric; MPN RC0402FR-0740K2L; LCSC C137983
R5, R15: 10k; R_0402_1005Metric; MPN RC0402FR-0710KL; LCSC C60490
R6: 75k; R_0402_1005Metric; MPN RC0402FR-0775KL; LCSC C137935
R7: 0; R_0402_1005Metric; MPN RC0402JR-070RL; LCSC C60485
R9: 13k; R_0402_1005Metric; MPN RC0402FR-0713KL; LCSC C138057
R10, R11: 1k; R_0402_1005Metric; MPN RC0402FR-071KL; LCSC C106235
R12: 22; R_0402_1005Metric; MPN RC0402FR-0722RL; LCSC C114765
R16: 0R; R_0402_1005Metric; MPN RC0402FR-070RL; LCSC C106231
R17: 0R; R_0402_1005Metric; MPN RC0402FR-070RL; LCSC C106231; not fitted
TF1: 5033981892; SDCARD_MOLEX_503398-1892; MPN 5033981892; LCSC C428492
Type_C1: USB4105-GF-A; USB_C_GCT_USB4105_GroundClearance_020; MPN USB4105-GF-A; LCSC C3020560
U1: MP1477GTF-Z; MP1658_SOT563_MPS; MPN MP1477GTF-Z; LCSC C3193189
U2, U5, U6, U7, U8, U10, U14, U16: TPD4EUSB30DQAR; TI_TPD4EUSB30_DQA0010A; MPN TPD4EUSB30DQAR; LCSC C90627
U3: RT9742CGJ5; SOT-23-5; MPN RT9742CGJ5; LCSC C250546
U4, U11: RT9742GGJ5; SOT-23-5; MPN RT9742GGJ5; LCSC C250547
U9: TPD4EUSB30DQAR; TI_TPD4EUSB30_DQA0010A_U9; MPN TPD4EUSB30DQAR; LCSC C90627
U15: 74LVC1G07SE-7; 74LVC1G07_SOT353_Diodes; MPN 74LVC1G07SE-7; LCSC C67531

Connections:
/5V: C1.2, C3.2, C4.1, C8.1, C10.1, C23.1, C26.1, C27.1, CM1.77 (+5v (Input)), CM1.79 (+5v (Input)), CM1.81 (+5v (Input)), CM1.83 (+5v (Input)), CM1.85 (+5v (Input)), CM1.87 (+5v (Input)), PI1.2 (5V), PI1.4 (5V), Type_C1.A4 (VBUS), Type_C1.A9 (VBUS), Type_C1.B4 (VBUS), Type_C1.B9 (VBUS), U1.1 (VIN), U3.5 (IN), U11.5 (IN)
/CAM_GPIO0: CM1.97 (CAM_GPIO0), J1.6 (GPIO0), J3.6 (GPIO0), U14.4 (I/O3), U14.7 (NC)
/CAM_GPIO1: CM1.100 (CAM_GPIO1), J1.5 (GPIO1), J3.5 (GPIO1), U14.5 (I/O4), U14.6 (NC)
/CC1: CM1.94 (CC1), Type_C1.A5 (CC1)
/CC2: CM1.96 (CC2), Type_C1.B5 (CC2)
/CM4_1V8: CM1.88 (+1.8v (Output)), CM1.90 (+1.8v (Output)), R17.2
/CM4_3V3: C11.2, C25.1, CM1.84 (+3.3v (Output)), CM1.86 (+3.3v (Output)), R5.1, R10.1, R11.2, R15.2, R16.2, U4.5 (IN), U15.5 (VCC)
/FAN_5V: C24.2, H4.1 (FAN_5V), U11.1 (OUT)
/FAN_PWM: CM1.19 (Fan_PWM), H4.2 (FAN_PWM)
/FAN_TACHO: CM1.16 (Fan_Tacho), H4.4 (FAN_TACHO)
/FB1:0.8V: C5.1, R3.2, R6.2, R9.1
/GPIO2: CM1.58 (GPIO2), PI1.3 (GPIO2)
/GPIO3: CM1.56 (GPIO3), PI1.5 (GPIO3)
/GPIO4: CM1.54 (GPIO4), PI1.7 (GPIO4)
/GPIO5: CM1.34 (GPIO5), PI1.29 (GPIO5)
/GPIO6: CM1.30 (GPIO6), PI1.31 (GPIO6)
/GPIO7: CM1.37 (GPIO7), PI1.26 (GPIO7)
/GPIO8: CM1.39 (GPIO8), PI1.24 (GPIO8)
/GPIO9: CM1.40 (GPIO9), PI1.21 (GPIO9)
/GPIO10: CM1.44 (GPIO10), PI1.19 (GPIO10)
/GPIO11: CM1.38 (GPIO11), PI1.23 (GPIO11)
/GPIO12: CM1.31 (GPIO12), PI1.32 (GPIO12)
/GPIO13: CM1.28 (GPIO13), PI1.33 (GPIO13)
/GPIO14: CM1.55 (GPIO14), PI1.8 (GPIO14)
/GPIO15: CM1.51 (GPIO15), PI1.10 (GPIO15)
/GPIO16: CM1.29 (GPIO16), PI1.36 (GPIO16)
/GPIO17: CM1.50 (GPIO17), PI1.11 (GPIO17)
/GPIO18: CM1.49 (GPIO18), PI1.12 (GPIO18)
/GPIO19: CM1.26 (GPIO19), PI1.35 (GPIO19)
/GPIO20: CM1.27 (GPIO20), PI1.38 (GPIO20)
/GPIO21: CM1.25 (GPIO21), PI1.40 (GPIO21)
/GPIO22: CM1.46 (GPIO22), PI1.15 (GPIO22)
/GPIO23: CM1.47 (GPIO23), PI1.16 (GPIO23)
/GPIO24: CM1.45 (GPIO24), PI1.18 (GPIO24)
/GPIO25: CM1.41 (GPIO25), PI1.22 (GPIO25)
/GPIO26: CM1.24 (GPIO26), PI1.37 (GPIO26)
/GPIO27: CM1.48 (GPIO27), PI1.13 (GPIO27)
/GPIO_VREF: CM1.78 (GPIO_VREF), CM-R2.1, CM-R3.1, R16.1, R17.1
/ID_SC: CM1.35 (ID_SC), CM-R2.2, J3.3 (SCL), PI1.28 (ID_SC), U10.4 (I/O3), U10.7 (NC)
/ID_SD: CM1.36 (ID_SD), CM-R3.2, J3.2 (SDA), PI1.27 (ID_SD), U10.5 (I/O4), U10.6 (NC)
/LED_G: CM1.21 (Pi_nLED_Activity), D2.1 (K)
/MIPI0_CLK_N: CM2.27 (MIPI0_C_N), J1.15 (CLK_N), U7.1 (I/O1), U7.10 (NC)
/MIPI0_CLK_P: CM2.29 (MIPI0_C_P), J1.14 (CLK_P), U7.2 (I/O2), U7.9 (NC)
/MIPI0_D0_N: CM2.15 (MIPI0_D0_N), J1.21 (D0_N), U5.1 (I/O1), U5.10 (NC)
/MIPI0_D0_P: CM2.17 (MIPI0_D0_P), J1.20 (D0_P), U5.2 (I/O2), U5.9 (NC)
/MIPI0_D1_N: CM2.21 (MIPI0_D1_N), J1.18 (D1_N), U5.4 (I/O3), U5.7 (NC)
/MIPI0_D1_P: CM2.23 (MIPI0_D1_P), J1.17 (D1_P), U5.5 (I/O4), U5.6 (NC)
/MIPI0_D2_N: CM2.33 (MIPI0_D2_N), J1.12 (D2_N), U7.4 (I/O3), U7.7 (NC)
/MIPI0_D2_P: CM2.35 (MIPI0_D2_P), J1.11 (D2_P), U7.5 (I/O4), U7.6 (NC)
/MIPI0_D3_N: CM2.39 (MIPI0_D3_N), J1.9 (D3_N), U14.1 (I/O1), U14.10 (NC)
/MIPI0_D3_P: CM2.41 (MIPI0_D3_P), J1.8 (D3_P), U14.2 (I/O2), U14.9 (NC)
/MIPI1_CLK_N: CM2.87 (MIPI1_C_N), J3.15 (CLK_N), U9.1 (I/O1), U9.10 (NC)
/MIPI1_CLK_P: CM2.89 (MIPI1_C_P), J3.14 (CLK_P), U9.2 (I/O2), U9.9 (NC)
/MIPI1_D0_N: CM2.75 (MIPI1_D0_N), J3.21 (D0_N), U8.1 (I/O1), U8.10 (NC)
/MIPI1_D0_P: CM2.77 (MIPI1_D0_P), J3.20 (D0_P), U8.2 (I/O2), U8.9 (NC)
/MIPI1_D1_N: CM2.81 (MIPI1_D1_N), J3.18 (D1_N), U8.4 (I/O3), U8.7 (NC)
/MIPI1_D1_P: CM2.83 (MIPI1_D1_P), J3.17 (D1_P), U8.5 (I/O4), U8.6 (NC)
/MIPI1_D2_N: CM2.93 (MIPI1_D2_N), J3.12 (D2_N), U9.4 (I/O3), U9.7 (NC)
/MIPI1_D2_P: CM2.95 (MIPI1_D2_P), J3.11 (D2_P), U9.5 (I/O4), U9.6 (NC)
/MIPI1_D3_N: CM2.94 (MIPI1_D3_N), J3.9 (D3_N), U10.1 (I/O1), U10.10 (NC)
/MIPI1_D3_P: CM2.96 (MIPI1_D3_P), J3.8 (D3_P), U10.2 (I/O2), U10.9 (NC)
/MIPI_3.3V: C5.2, C6.2, C7.2, C14.2, C15.2, C16.2, C18.2, C20.2, J1.1 (3V3), J3.1 (3V3), L1.2, PI1.1 (MIPI_3.3V), PI1.17 (MIPI_3.3V), R3.1
/NetC2_1: C2.1, L1.1, U1.2 (SW)
/NetC2_2: C2.2, R2.1
/NetLed1_1: D1.2 (A), R10.2
/NetLed1_2: D2.2 (A), R11.1
/NetR2_2: R2.2, U1.4 (BST)
/NetR6_1: R6.1, U1.6 (FB)
/NetR7_2: R7.2, U11.4 (EN)
/NetR12_2: R12.2, TF1.5 (CLK)
/PI_BOOT: CM1.93 (nRPIBOOT), Key1.2
/PI_PWR_LED: CM1.95 (PI_LED_nPWR), U15.2
/PWR_BUTTON: CM1.92 (PWR_Button), Key2.2
/PWR_EN: C17.1, R5.2, U1.5 (EN)
/PWR_LED_SINK: D1.1 (K), U15.4
/RTC_VDD: C19.1, CM1.76 (RTC_VBAT), H3.1 (RTC_VDD)
/SCL0: CM1.80 (SCL0), J1.3 (SCL)
/SDA0: CM1.82 (SDA0), J1.2 (SDA)
/SD_3.3V: C12.1, C13.2, TF1.4 (VDD), U4.1 (OUT)
/SD_CLK: CM1.57 (SD_CLK), R12.1
/SD_CMD: CM1.62 (SD_CMD), TF1.3 (CMD)
/SD_DAT0: CM1.63 (SD_DAT0), TF1.7 (DAT0)
/SD_DAT1: CM1.67 (SD_DAT1), TF1.8 (DAT1)
/SD_DAT2: CM1.69 (SD_DAT2), TF1.1 (DAT2)
/SD_DAT3: CM1.61 (SD_DAT3), TF1.2 (DAT3)
/SD_PWREN: CM1.75 (SD_PWR_ON), R15.1, U4.4 (EN)
/USB0_N: CM2.3 (USB_N), Type_C1.A7 (D-), Type_C1.B7 (D-), U16.1 (I/O1), U16.10 (NC)
/USB0_P: CM2.5 (USB_P), Type_C1.A6 (D+), Type_C1.B6 (D+), U16.2 (I/O2), U16.9 (NC)
/USB3-0-D_N: CM2.36 (USB3-0-DM), J2.2 (D-), U2.4 (I/O3), U2.7 (NC)
/USB3-0-D_P: CM2.34 (USB3-0-DP), J2.3 (D+), U2.5 (I/O4), U2.6 (NC)
/USB3-0-RX_N: CM2.28 (USB3-0-RX_N), J2.5 (SSRX-), U6.1 (I/O1), U6.10 (NC)
/USB3-0-RX_P: CM2.30 (USB3-0-RX_P), J2.6 (SSRX+), U6.2 (I/O2), U6.9 (NC)
/USB3-0-TX_N: CM2.40 (USB3-0-TX_N), J2.8 (SSTX-), U2.1 (I/O1), U2.10 (NC)
/USB3-0-TX_P: CM2.42 (USB3-0-TX_P), J2.9 (SSTX+), U2.2 (I/O2), U2.9 (NC)
/USB_5V: C9.1, J2.1 (VBUS), U3.1 (OUT)
/VBUS_EN: CM2.11 (VBUS_EN), R7.1, U3.4 (EN)
GND: C1.1, C3.1, C4.2, C6.1, C7.1, C8.2, C9.2, C10.2, C11.1, C12.2, C13.1, C14.1, C15.1, C16.1, C17.2, C18.1, C19.2, C20.1, C23.2, C24.1, C25.2, C26.2, C27.2, CM1.1 (GND), CM1.2 (GND), CM1.7 (GND), CM1.8 (GND), CM1.13 (GND), CM1.14 (GND), CM1.22 (GND), CM1.23 (GND), CM1.32 (GND), CM1.33 (GND), CM1.42 (GND), CM1.43 (GND), CM1.52 (GND), CM1.53 (GND), CM1.59 (GND), CM1.60 (GND), CM1.65 (GND), CM1.66 (GND), CM1.71 (GND), CM1.74 (GND), CM1.98 (GND), CM2.7 (GND), CM2.8 (GND), CM2.13 (GND), CM2.14 (GND), CM2.19 (GND), CM2.20 (GND), CM2.25 (GND), CM2.26 (GND), CM2.31 (GND), CM2.32 (GND), CM2.37 (GND), CM2.38 (GND), CM2.44 (GND), CM2.50 (GND), CM2.55 (GND), CM2.56 (GND), CM2.61 (GND), CM2.62 (GND), CM2.67 (GND), CM2.68 (GND), CM2.73 (GND), CM2.74 (GND), CM2.79 (GND), CM2.80 (GND), CM2.85 (GND), CM2.86 (GND), CM2.91 (GND), CM2.92 (GND), CM2.97 (GND), CM2.98 (GND), H3.2 (GND), H3.MP (SHIELD), H4.3 (GND), H4.MP (SHIELD), J1.4 (GND), J1.7 (GND), J1.10 (GND), J1.13 (GND), J1.16 (GND), J1.19 (GND), J1.22 (GND), J1.MP (SHIELD), J2.4 (GND), J2.7 (DRAIN), J2.SH (SHIELD), J3.4 (GND), J3.7 (GND), J3.10 (GND), J3.13 (GND), J3.16 (GND), J3.19 (GND), J3.22 (GND), J3.MP (SHIELD), Key1.1, Key2.1, PI1.6 (GND), PI1.9 (GND), PI1.14 (GND), PI1.20 (GND), PI1.25 (GND), PI1.30 (GND), PI1.34 (GND), PI1.39 (GND), R9.2, TF1.6 (GND), TF1.11 (SHIELD), Type_C1.A1 (GND), Type_C1.A12 (GND), Type_C1.B1 (GND), Type_C1.B12 (GND), Type_C1.SH (SHIELD), U1.3 (GND), U2.3 (GND), U2.8 (GND), U3.2 (GND), U4.2 (GND), U5.3 (GND), U5.8 (GND), U6.3 (GND), U6.8 (GND), U7.3 (GND), U7.8 (GND), U8.3 (GND), U8.8 (GND), U9.3 (GND), U9.8 (GND), U10.3 (GND), U10.8 (GND), U11.2 (GND), U14.3 (GND), U14.8 (GND), U15.3 (GND), U16.3 (GND), U16.8 (GND)

Notes on the sheet:
CM5 NANO COMPATIBLE - FUNCTIONAL CARRIER - ENGINEERING DESIGN
55 x 40 mm target | CM5 / CM5 Lite | USB-C 5 V input + USB0 recovery | single USB3 host | dual 4-lane MIPI | GPIO | SD | fan | RTC
New physical parts and reviewed contact mappings. Prototype verification and PCB layout remain required. Do not order from schematic alone.
CM5 module contacts / GPIO voltage selection / controls
USB-C power + recovery
CM5 Lite microSD supply
3.3 V peripheral regulator - sequenced by CM5_3V3
Host power and indicators
Fan and RTC
MIPI0 protection
MIPI1 protection
H2: fit shunt 2-3 for default 3.3V; 1-2 selects 1.8V. Power OFF before changing. GPIO bank follows VREF; header 3.3V pins remain 3.3V. MIPI1 / HAT I2C follows GPIO_VREF; verify peripherals in 1.8V mode.
BOOT: hold during power-up for USB recovery. POWER: module power button. CM5 eMMC uses onboard storage; external microSD applies only to CM5 Lite.
USB-C is the 5V input and USB2 device/recovery port. CM5 CC1/CC2 negotiate power; no external 5.1k Rd. GPIO 5V is directly the same rail; use one supply at a time.
Power declarations: USB-C supplies 5V and GND; GPIO_VREF is supplied through the fitted H2 shunt (default 2-3).
USB3 SuperSpeed ESD
USB0 connector-local ESD (separate from USB3 RX)

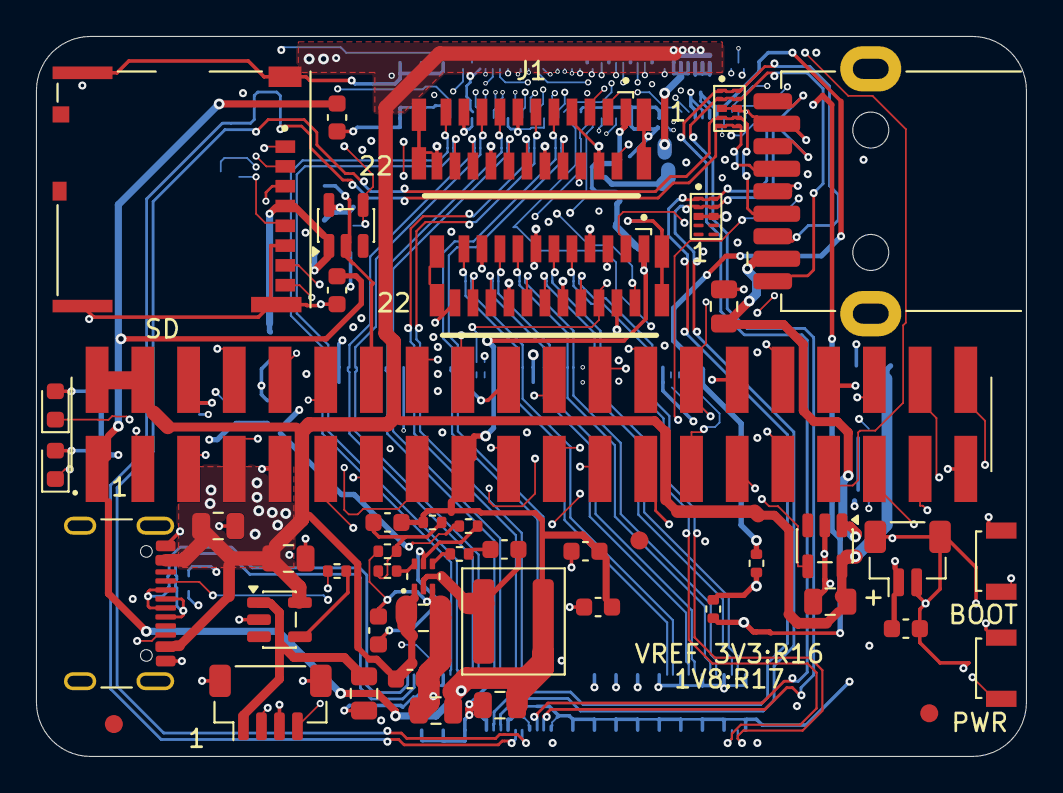
[picture p18: board cm5-nano-compatible.kicad_pcb from above]

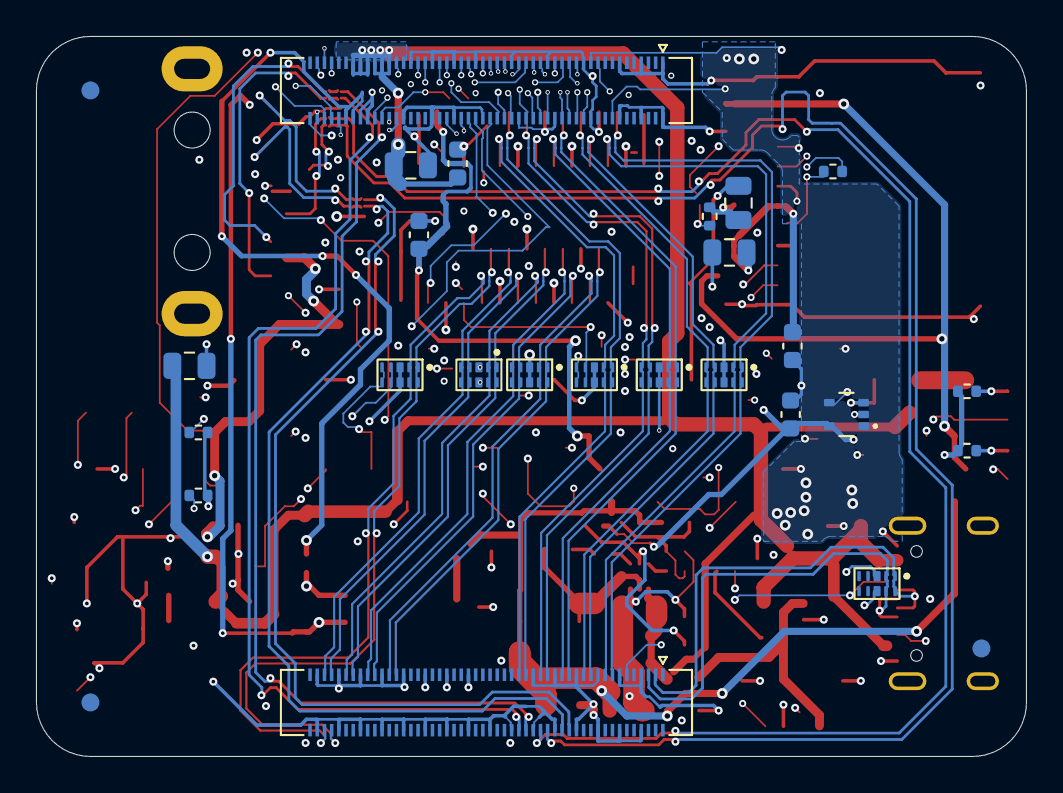
[picture p19: board cm5-nano-compatible.kicad_pcb from below]

Board: 8 copper layers, 55.0 x 40.0 mm, 74 parts (27 on the bottom side), 97 nets.

Other parts of the board:
FID1, FID2, FID3, FID4, FID5, FID6: Fiducial; Fiducial_1mm_Mask2mm
